Friday-Labs-Inc/friday-labs-os/docs/build/Locomotion Deck - Full Schematic.pdf

FRIDAY LABS - MARK 1 | Power, Isolation Domains & E-Stop

## BACKBONE INPUT

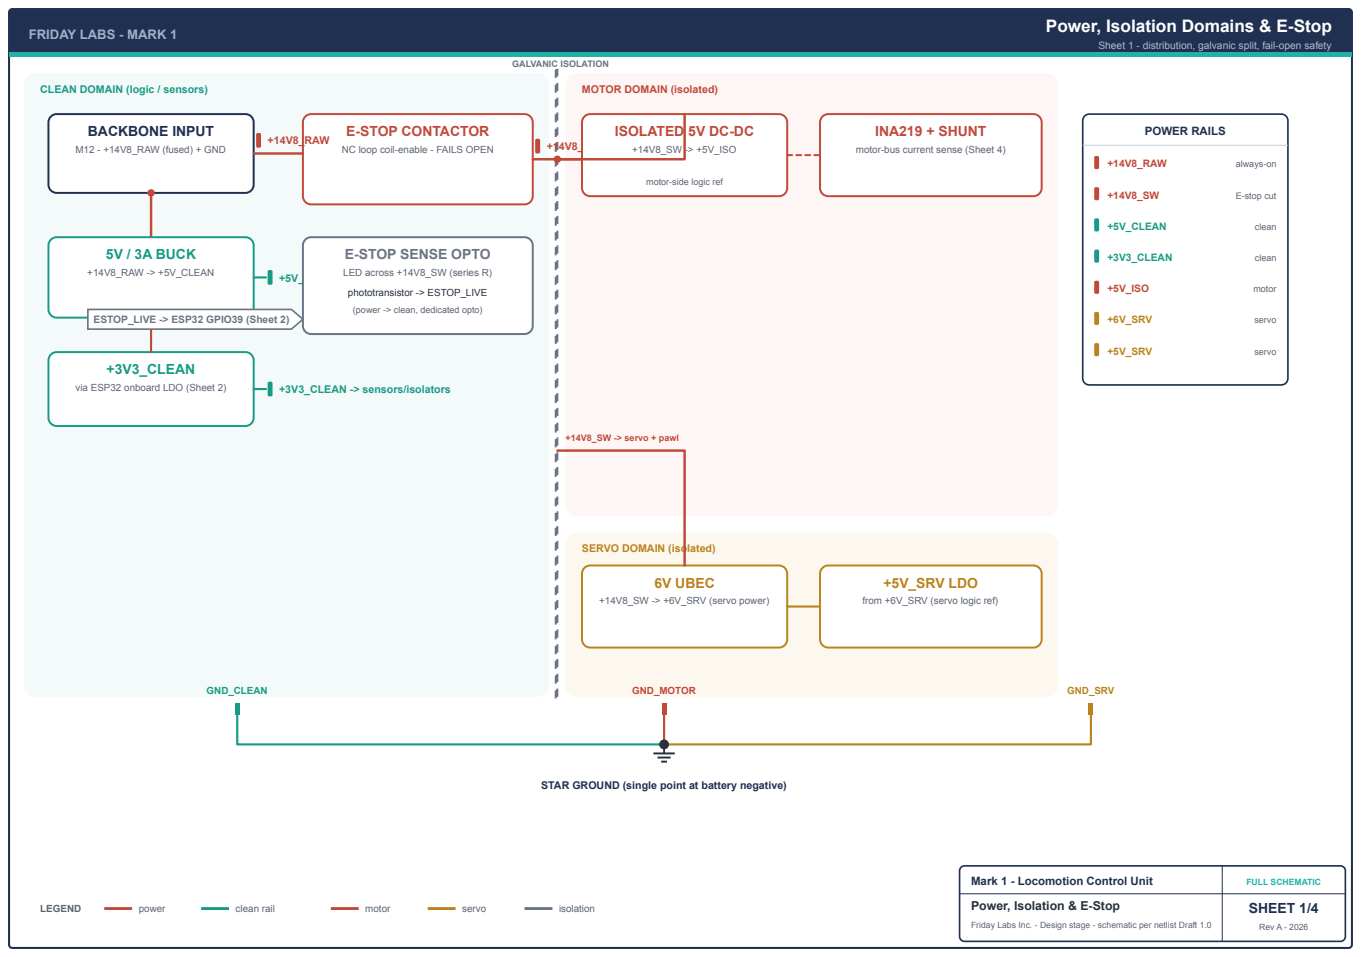
[picture p1: page 1]
CLEAN DOMAIN (logic / sensors); MOTOR DOMAIN (isolated); GALVANIC ISOLATION; M12 - +14V8_RAW (fused) + GND; E-STOP CONTACTOR; NC loop coil-enable - FAILS OPEN +14V8_RAW; 5V / 3A BUCK; +14V8_RAW -> +5V_CLEAN; +5V_CLEAN -> ESP32 (Sheet 2); +3V3_CLEAN -> sensors/isolators; ESTOP_LIVE -> ESP32 GPIO39 (Sheet 2); 6V UBEC; +14V8_SW -> +6V_SRV (servo power); +14V8_SW -> servo + pawl; POWER RAILS; +14V8_RAW; always-on; E-stop cut; +5V_CLEAN; clean; +3V3_CLEAN; +5V_ISO; motor; +6V_SRV; servo; +5V_SRV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

Sheet 1 - distribution, galvanic split, fail-open safety

ISOLATED 5V DC-DC
+14V8_SW -> +5V_ISO

INA219 + SHUNT
motor-bus current sense (Sheet 4)

motor-side logic ref

E-STOP SENSE OPTO
LED across +14V8_SW (series R)
phototransistor -> ESTOP_LIVE
(power -> clean, dedicated opto)

+3V3_CLEAN
via ESP32 onboard LDO (Sheet 2)

SERVO DOMAIN (isolated)

+5V_SRV LDO
from +6V_SRV (servo logic ref)

STAR GROUND (single point at battery negative)

Mark 1 - Locomotion Control Unit
Power, Isolation & E-Stop

Friday Labs Inc. - Design stage - schematic per netlist Draft 1.0

FRIDAY LABS - MARK 1 | Controller, I2C Sensors & Isolation Bank Sheet 2 - ESP32-S3 pinout, encoder mux tree, current-sense isolation

### ISOLATION BANK (ISO7741 x5)

#1 | DRV_PWM1..4 -> MDD10A PWM

#2 | DRV_PWM5-6, DIR1-2

#3 | DRV_DIR3..6

#4 | SRV_PWM1..4 -> servos

#5 | PAWL_REL -> FET (+3 spare)

All ISO7741 channels run clean -> power (4/0 part). E-stop sense is a separate opto (Sheet 1).

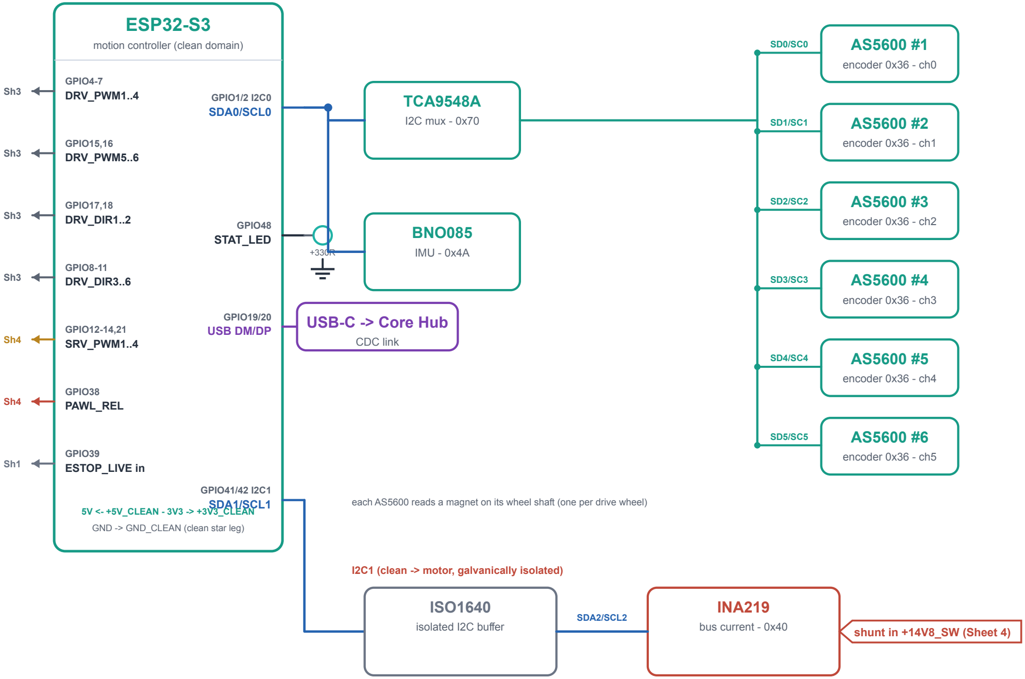
[picture p2: figure]
ESP32-S3; motion controller (clean domain); GPIO4-7 DRV_PWM1..4 Sh3; GPIO15,16 DRV_PWM5..6 Sh3; GPIO17,18 DRV_DIR1..2 Sh3; GPIO8-11 DRV_DIR3..6 Sh3; GPIO12-14,21 SRV_PWM1..4 Sh4; GPIO38 PAWL_REL Sh4; GPIO39 ESTOP_LIVE in Sh1; GPIO1/2 I2C0 SDA0/SCL0; GPIO48 STAT_LED; GPIO19/20 USB DM/DP; GPIO41/42 I2C1; GND -> GND_CLEAN (clean star leg); USB-C -> Core Hub; CDC link; TCA9548A; I2C mux - 0x70; BNO085; IMU - 0x4A; encoder 0x36 - ch0; encoder 0x36 - ch1; encoder 0x36 - ch2; encoder 0x36 - ch3; encoder 0x36 - ch4; encoder 0x36 - ch5; ISO1640; isolated I2C buffer; INA219; bus current - 0x40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

SDA1/SCL1 5V <- +5V_CLEAN - 3V3 -> +3V3_CLEAN

I2C0 (clean) - mux, IMU + 6 wheel encoders - pull-ups 4.7k -> +3V3_CLEAN

each AS5600 reads a magnet on its wheel shaft (one per drive wheel)

I2C1 (clean -> motor, galvanically isolated)

VCC1 3V3 / VCC2 +5V_ISO - pull-ups both sides

LEGEND | I2C | control | USB

### Mark 1 - Locomotion Control Unit

## Controller, Sensors & Isolation

FULL SCHEMATIC

## SHEET 2/4

FRIDAY LABS - MARK 1 | Drive Subsystem - 6 Channels (fully expanded) Sheet 3 - ESP32 -> ISO7741 x3 -> MDD10A x3 -> 6 drive motors

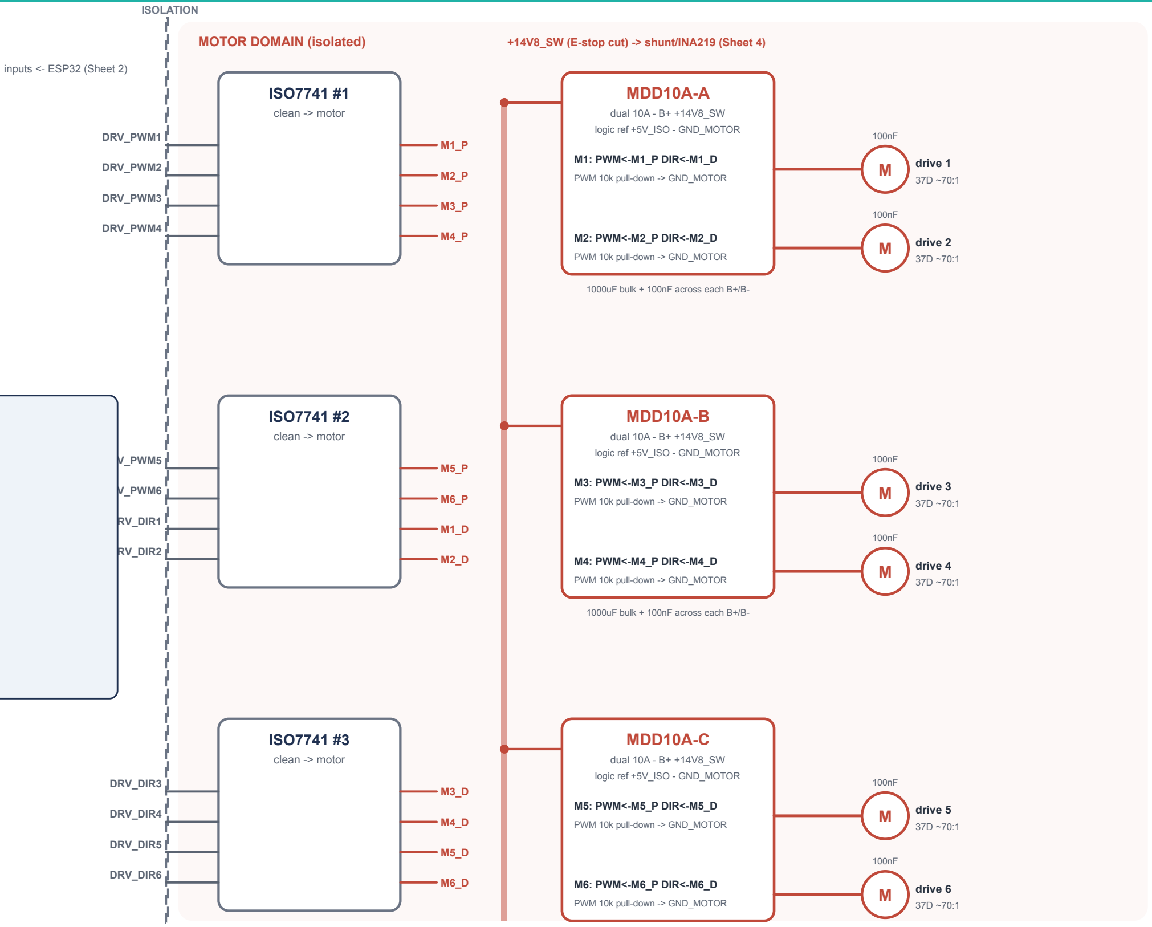
[picture p3: figure]
MOTOR DOMAIN (isolated); ISOLATION; inputs <- ESP32 (Sheet 2); ISO7741 #1; clean -> motor; DRV_PWM1; DRV_PWM2; DRV_PWM3; DRV_PWM4; ISO7741 #2; DRV_PWM5; DRV_PWM6; DRV_DIR1; DRV_DIR2; ISO7741 #3; DRV_DIR3; DRV_DIR4; DRV_DIR5; DRV_DIR6; MDD10A-A; dual 10A - B+ +14V8_SW; logic ref +5V_ISO - GND_MOTOR; M1: PWM<-M1_P DIR<-M1_D; PWM 10k pull-down -> GND_MOTOR; drive 1; M2: PWM<-M2_P DIR<-M2_D; drive 2; 1000uF bulk + 100nF across each B+/B-; MDD10A-B; M3: PWM<-M3_P DIR<-M3_D; drive 3; M4: PWM<-M4_P DIR<-M4_D; drive 4; MDD10A-C; M5: PWM<-M5_P DIR<-M5_D; drive 5; M6: PWM<-M6_P DIR<-M6_D; drive 6

1000uF bulk + 100nF across each B+/B-

+14V8_SW (E-stop cut) -> shunt/INA219 (Sheet 4)

### FAIL-SAFE ON SIGNAL LOSS

- Dead isolator / lost PWM -> motor-side 10k pull-down -> PWM low -> motor OFF.
- E-stop opens +14V8_SW -> MDD10A B+ removed -> all 6 drive motors dead.
- Pull-downs live on the isolated (power) side: hold the
safe state even if clean domain / isolators are unpowered.
- 37D-class gearmotor; AS5600 shaft encoder feedback
on I2C0 mux (Sheet 2).

Drive map: A=M1,M2 - B=M3,M4 - C=M5,M6

LEGEND | control | motor signal | power

### Mark 1 - Locomotion Control Unit

## Drive Subsystem x6

FULL SCHEMATIC

## SHEET 3/4

FRIDAY LABS - MARK 1 | Steering, Parking Pawls & Current Sense Sheet 4 - 4 steer servos, power-to-release pawls, motor-bus INA219

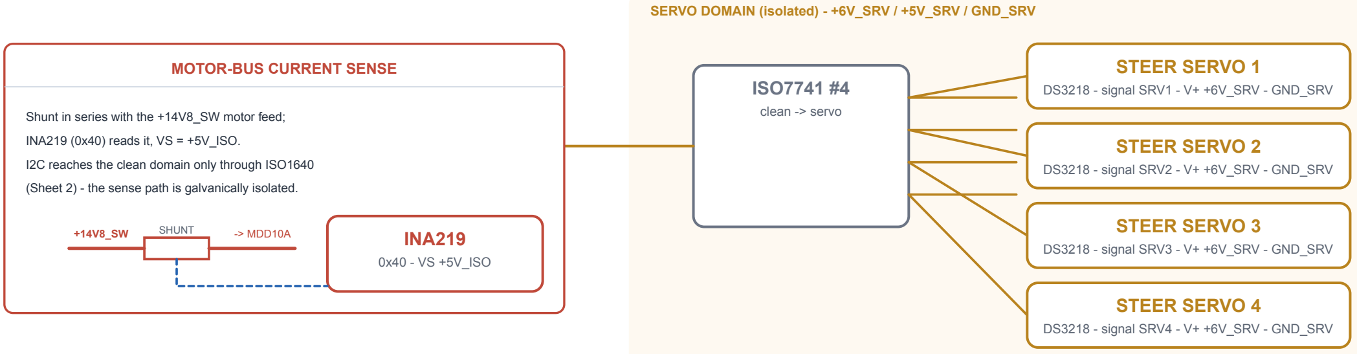
[picture p4: figure]
ISO7741 #4; clean -> servo; SRV_PWM1..4 (Sheet 2); STEER SERVO 1; STEER SERVO 2; STEER SERVO 3; STEER SERVO 4; MOTOR-BUS CURRENT SENSE; INA219 (0x40) reads it, VS = +5V_ISO.; SHUNT +14V8_SW; -> MDD10A; INA219; 0x40 - VS +5V_ISO

SERVO DOMAIN (isolated) - +6V_SRV / +5V_SRV / GND_SRV

DS3218 - signal SRV1 - V+ +6V_SRV - GND_SRV

DS3218 - signal SRV2 - V+ +6V_SRV - GND_SRV

DS3218 - signal SRV3 - V+ +6V_SRV - GND_SRV

DS3218 - signal SRV4 - V+ +6V_SRV - GND_SRV

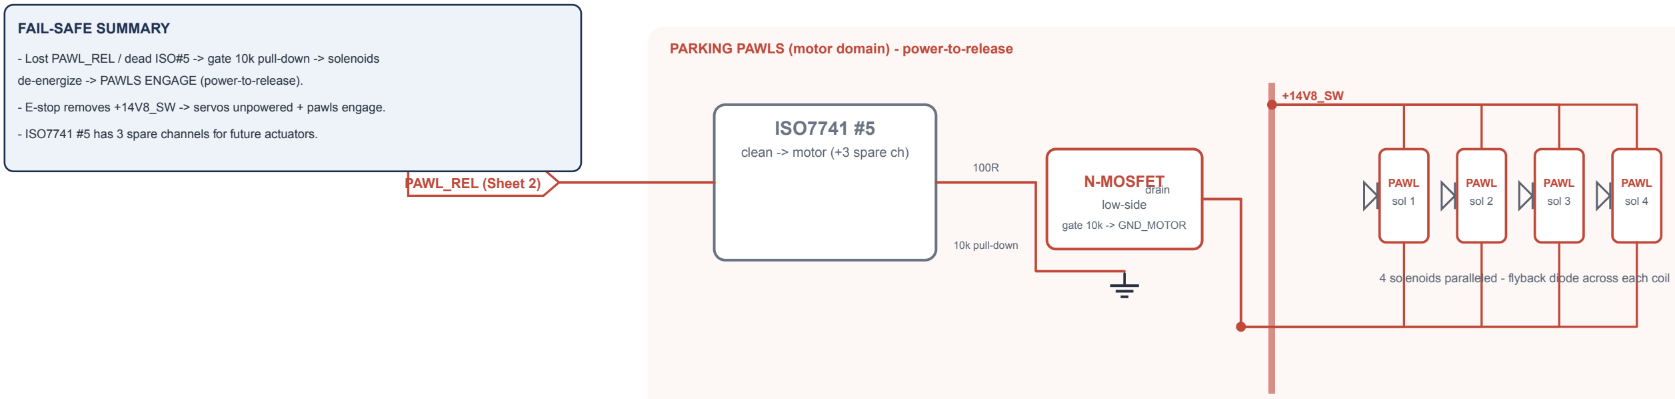
[picture p5: figure]
ISO7741 #5; clean -> motor (+3 spare ch); PAWL_REL (Sheet 2); N-MOSFET; low-side; gate 10k -> GND_MOTOR; 10k pull-down; drain; PAWL; sol 1; PAWL sol 2; PAWL sol 3; PAWL sol 4; FAIL-SAFE SUMMARY; de-energize -> PAWLS ENGAGE (power-to-release).

PARKING PAWLS (motor domain) - power-to-release

4 solenoids paralleled - flyback diode across each coil

Shunt in series with the +14V8_SW motor feed;

I2C reaches the clean domain only through ISO1640 (Sheet 2) - the sense path is galvanically isolated.

- Lost PAWL_REL / dead ISO#5 -> gate 10k pull-down -> solenoids
- E-stop removes +14V8_SW -> servos unpowered + pawls engage.
- ISO7741 #5 has 3 spare channels for future actuators.
LEGEND | servo signal | motor | power | I2C

### Mark 1 - Locomotion Control Unit

## Steering, Pawls & Current Sense

FULL SCHEMATIC

## SHEET 4/4
