Friday-Labs-Inc/friday-labs-os/frames_2026-07-19_11.41.01.pdf

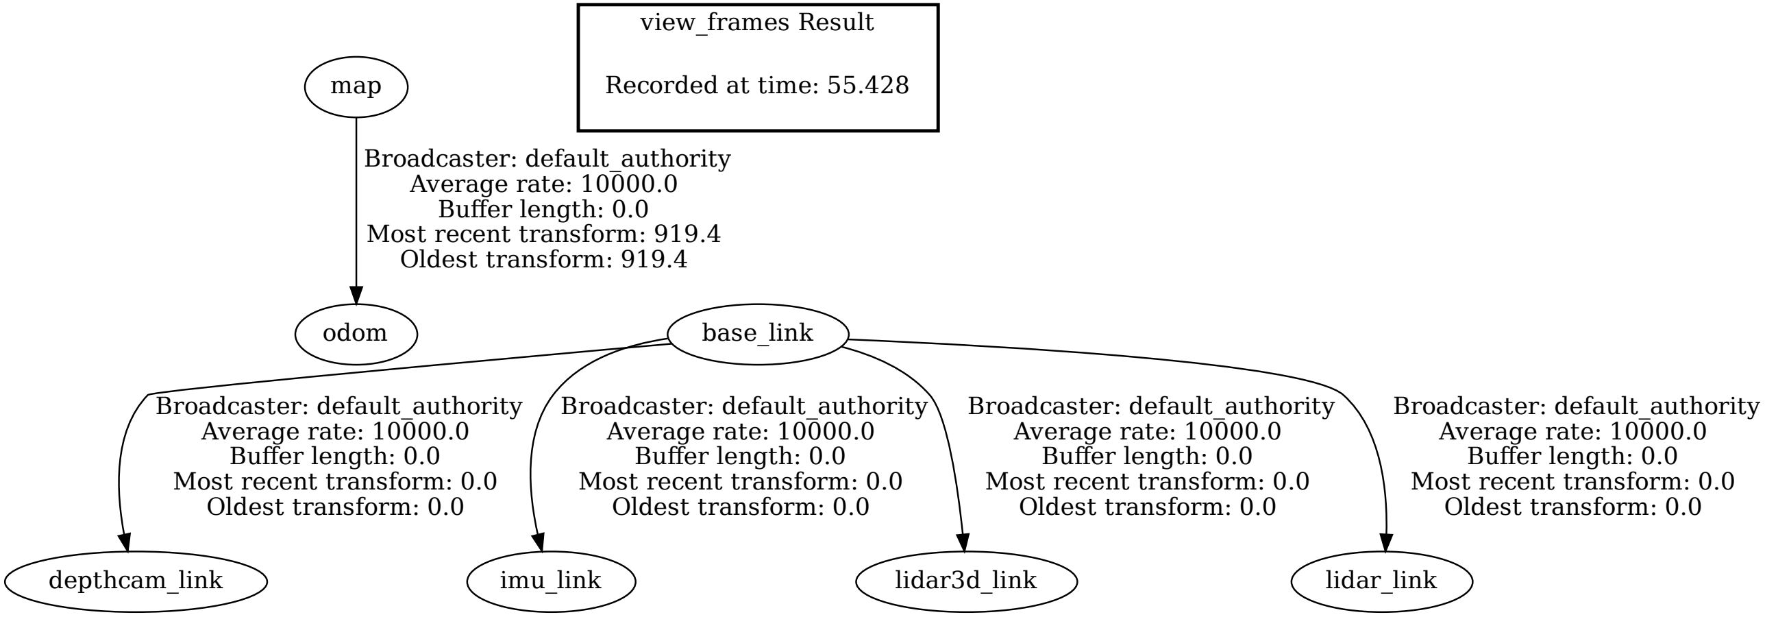
[picture p6: figure]
view_frames Result; map; odom; Broadcaster: default_authority Average rate: 10000.0 Buffer length: 0.0 Most recent transform: 919.4 Oldest transform: 919.4; base_link; depthcam_link; Broadcaster: default_authority Average rate: 10000.0 Buffer length: 0.0 Most recent transform: 0.0 Oldest transform: 0.0; imu_link; lidar3d_link; lidar_link; Recorded at time: 55.428
