Friday-Labs-Inc/friday-labs-os/(list of files, cad)

Other CAD files:
Mechanics/reference-models/howtomechatronics-replica/Perseverance_Replica_Assembly.step
Mechanics/reference-models/howtomechatronics-replica/stl/Accessories - Not functional parts/Accessories - front panels.STL
Mechanics/reference-models/howtomechatronics-replica/stl/Cameras Unit/Cam base motor mount.STL
Mechanics/reference-models/howtomechatronics-replica/stl/Main Functional Parts/Wheel 5 joint motor mount - Mirrored.STL
src/friday_description/meshes/knuckle_fl.stl
Mechanics/reference-models/howtomechatronics-replica/stl/Accessories - Not functional parts/Accessories p19-2.STL
Mechanics/reference-models/howtomechatronics-replica/stl/Cameras Unit/Cams servo mount.STL
Mechanics/reference-models/howtomechatronics-replica/stl/Main Functional Parts/Base frame back bracket v2.STL
src/friday_description/meshes/wheel.stl
Mechanics/reference-models/howtomechatronics-replica/stl/Accessories - Not functional parts/UHF Antenna.STL
Mechanics/reference-models/howtomechatronics-replica/stl/Cameras Unit/Cams tube p3.STL
Mechanics/reference-models/howtomechatronics-replica/stl/Main Functional Parts/Rim and DC Motor Coupler.STL
src/friday_description/meshes/chassis.stl
Mechanics/reference-models/howtomechatronics-replica/stl/Accessories - Not functional parts/Accessories p15-3.STL
Mechanics/reference-models/howtomechatronics-replica/stl/Cameras Unit/Cams servo link.STL
Mechanics/reference-models/howtomechatronics-replica/stl/Main Functional Parts/Wheel 3 Joint Servo Mount.STL
src/friday_description/meshes/knuckle_fr.stl
Mechanics/reference-models/howtomechatronics-replica/stl/Accessories - Not functional parts/Accessories p6-2 mirrored.STL
Mechanics/reference-models/howtomechatronics-replica/stl/Cameras Unit/Cams accessories 3.STL
Mechanics/reference-models/howtomechatronics-replica/stl/Main Functional Parts/Diff bar link.STL
Mechanics/reference-models/howtomechatronics-replica/stl/Accessories - Not functional parts/Accessories p5 holder.STL
Mechanics/reference-models/howtomechatronics-replica/stl/Cameras Unit/Cams accessories.STL
Mechanics/reference-models/howtomechatronics-replica/stl/Main Functional Parts/Wheel 1 Joint Servo Mount.STL
Mechanics/reference-models/howtomechatronics-replica/stl/Accessories - Not functional parts/Accessoires p1-2.STL
Mechanics/reference-models/howtomechatronics-replica/stl/Cameras Unit/Cams accessories 2.STL
Mechanics/reference-models/howtomechatronics-replica/stl/Main Functional Parts/Bogie joint p1.STL
Mechanics/reference-models/howtomechatronics-replica/stl/Accessories - Not functional parts/Accessories p20-1.STL
Mechanics/reference-models/howtomechatronics-replica/stl/Cameras Unit/Cams servo mount p2.STL
Mechanics/reference-models/howtomechatronics-replica/stl/Main Functional Parts/Wheel v.1.STL
Mechanics/reference-models/howtomechatronics-replica/stl/Accessories - Not functional parts/Accessories p19 - top panel.STL
Mechanics/reference-models/howtomechatronics-replica/stl/Cameras Unit/Cams accesories 1-2.STL
Mechanics/reference-models/howtomechatronics-replica/stl/Main Functional Parts/Bogie Joint p2.STL
Mechanics/reference-models/howtomechatronics-replica/stl/Accessories - Not functional parts/Accessories p2 - back right - mirrored.STL
Mechanics/reference-models/howtomechatronics-replica/stl/Cameras Unit/Cams accessories 5.STL
Mechanics/reference-models/howtomechatronics-replica/stl/Main Functional Parts/Rim.STL
Mechanics/reference-models/howtomechatronics-replica/stl/Accessories - Not functional parts/RTG pipes 1.STL
Mechanics/reference-models/howtomechatronics-replica/stl/Cameras Unit/Cams tube 2.STL
Mechanics/reference-models/howtomechatronics-replica/stl/Main Functional Parts/Rocker joint p2 - Mirrored.STL
Mechanics/reference-models/howtomechatronics-replica/stl/Accessories - Not functional parts/Accessories p6.STL
Mechanics/reference-models/howtomechatronics-replica/stl/Cameras Unit/Cam base bracket.STL
Mechanics/reference-models/howtomechatronics-replica/stl/Main Functional Parts/Bogie Joint p2 - Mirrored.STL
Mechanics/reference-models/howtomechatronics-replica/stl/Accessories - Not functional parts/Accessories p19- top left.STL
Mechanics/reference-models/howtomechatronics-replica/stl/Cameras Unit/Cams accessories 4.STL
Mechanics/reference-models/howtomechatronics-replica/stl/Main Functional Parts/Differential Bar p2.STL
Mechanics/reference-models/howtomechatronics-replica/stl/Accessories - Not functional parts/Accessories p14.STL
Mechanics/reference-models/howtomechatronics-replica/stl/Cameras Unit/Camera holder.STL
Mechanics/reference-models/howtomechatronics-replica/stl/Main Functional Parts/Wheel 4 Joint Servo Mount - Mirrored.STL
Mechanics/reference-models/howtomechatronics-replica/stl/Accessories - Not functional parts/UHF Antenna base.STL
Mechanics/reference-models/howtomechatronics-replica/stl/Cameras Unit/Cam tube p1.STL
Mechanics/reference-models/howtomechatronics-replica/stl/Main Functional Parts/Differential Bar p1.STL
Mechanics/reference-models/howtomechatronics-replica/stl/Accessories - Not functional parts/Accessories p1 - 1.STL
Mechanics/reference-models/howtomechatronics-replica/stl/Cameras Unit/Cams housing top cover.STL
Mechanics/reference-models/howtomechatronics-replica/stl/Main Functional Parts/Electronics holder p1.STL
Mechanics/reference-models/howtomechatronics-replica/stl/Accessories - Not functional parts/Accessiories p1-1.STL
Mechanics/reference-models/howtomechatronics-replica/stl/Cameras Unit/Cams tube p4.STL
Mechanics/reference-models/howtomechatronics-replica/stl/Main Functional Parts/Servo coupler.STL
Mechanics/reference-models/howtomechatronics-replica/stl/Accessories - Not functional parts/Accessories p1 - 2.STL
Mechanics/reference-models/howtomechatronics-replica/stl/Cameras Unit/Cams accessories 2-1.STL
Mechanics/reference-models/howtomechatronics-replica/stl/Main Functional Parts/Electronics holder p2.STL
Mechanics/reference-models/howtomechatronics-replica/stl/Accessories - Not functional parts/Accessories p18.STL
Mechanics/reference-models/howtomechatronics-replica/stl/Cameras Unit/Cams housing.STL
Mechanics/reference-models/howtomechatronics-replica/stl/Main Functional Parts/Rocker joint base.STL
Mechanics/reference-models/howtomechatronics-replica/stl/Accessories - Not functional parts/RGT cover bracket.STL
Mechanics/reference-models/howtomechatronics-replica/stl/Cameras Unit/Cams cover bottom.STL
Mechanics/reference-models/howtomechatronics-replica/stl/Main Functional Parts/Shaft Coupler - 5mm to 5mm (v2 for 5mm pulleys).STL
Mechanics/reference-models/howtomechatronics-replica/stl/Accessories - Not functional parts/RTG pipes 3 - mirrored.STL
Mechanics/reference-models/howtomechatronics-replica/stl/Main Functional Parts/Bracker for dif bar.STL
Mechanics/reference-models/howtomechatronics-replica/stl/Accessories - Not functional parts/RTG support 1.STL
Mechanics/reference-models/howtomechatronics-replica/stl/Main Functional Parts/Rocker Joint.STL
Mechanics/reference-models/howtomechatronics-replica/stl/Accessories - Not functional parts/RTG pipes 2.STL
Mechanics/reference-models/howtomechatronics-replica/stl/Main Functional Parts/Wheel 2 joint motor mount.STL
Mechanics/reference-models/howtomechatronics-replica/stl/Accessories - Not functional parts/Accessories p14-2.STL
Mechanics/reference-models/howtomechatronics-replica/stl/Main Functional Parts/Wheel 1 Joint p2.STL
Mechanics/reference-models/howtomechatronics-replica/stl/Accessories - Not functional parts/RTG pipes 3.STL
Mechanics/reference-models/howtomechatronics-replica/stl/Main Functional Parts/Base frame front and back bracket.STL
Mechanics/reference-models/howtomechatronics-replica/stl/Accessories - Not functional parts/Accessories p17 - top front left.STL
Mechanics/reference-models/howtomechatronics-replica/stl/Main Functional Parts/Wheel 1 Joint.STL
Mechanics/reference-models/howtomechatronics-replica/stl/Accessories - Not functional parts/Accessories p21.STL
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
