Friday-Labs-Inc/friday-labs-os/(commit log)

2026-06-19 docs: initial commit — Phase 1 design dossier complete
    24 internally-aligned documents covering full Phase 1 design for the Mark 1
    modular autonomous research rover:
    - 5 foundational architecture docs (compute, OS, comms, interface contract,
    sim environment)
    - 13 design-gap addendums (authority lease, safe-stop budget, sensor ownership,
    power budget, AI inference, friday_msgs schema conventions, mTLS security,
    OTA strategy, mission logging, Stage 5 acceptance, Spark authority,
    mechanical reference, mmWave human detection)
    - 3 module specs (Locomotion Control Unit, Adaptive Research Module,
    Aerial Companion Bay)
    - Phase 1 Implementation Kickoff onboarding
    Plus 8 project-specific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
2026-06-19 docs: add deck-by-deck electronics design
    Six new electronics documents under docs/electronics/ capturing the full
    electrical design pass:
    - Electronics Backbone: distributed power tree (fused raw 14.8V per deck),
    NC-loop physical E-stop on motion power, single-point star ground, central
    fuse block + per-deck protection, M8/M12 bulkhead connectors, custom-PCB
    build medium, plus cross-cutting bus comparator / supercap / load switches.
    - Core Hub: 5V/6A buck->GPIO + usb_max_current_enable override, powered USB 3.0
    hub, conduction cooling, NVMe boot, supercap power-fail shutdown.
    - Telemetry: dual independent LoRa (Pi + ESP32), 4G LTE M.2 (5G-ready),
    backup-ESP32 reboot authority via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
2026-06-19 docs: add Locomotion deck build package (bottom deck)
    First buildable deck package, under docs/build/:
    - Electrical BOM with real, verifiable parts (Cytron MDD10A, ESP32-S3,
    Adafruit BNO085, AS5600 + TCA9548A, ISO7741/ISO1640 isolators, INA219,
    pawl solenoids) and ~costs.
    - ESP32-S3 pinout/wiring map: drive PWM on MCPWM, servo PWM on LEDC
    (solves the 10-PWM > 8-LEDC-channel constraint), dual I2C with the
    motor-domain INA219 behind an I2C isolator, fail-safe-on-signal-loss
    control lines across the galvanic barrier.
    - Power-domain & isolation diagram: clean / motor / servo domains meeting
    only at the battery-negative star point.
    - Layered safe-stop wiring (software brake -> 100ms w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
2026-06-19 docs: resolve Locomotion drive-motor sizing
    Worked the drive-motor sizing calc (11kg, 130mm wheels, 20 deg climb,
    1 m/s, 6WD, Crr=0.10):
    - Wheel speed ~147 RPM; tractive force 47 N; 0.51 N.m/motor steady,
    design target >=1.0 N.m stall.
    - Motor: 12V 37D-class ~70:1 (~150 RPM, ~1.2-1.3 N.m stall, ~5.5A stall).
    - Confirms 10 A/channel driver (~1.8x stall headroom) -> Cytron 10A class.
    - Firmware note: cap drive PWM duty ~71% so the 4S bus (up to 16.8V)
    doesn't over-volt 12V motors.
    - Power note: sustained 20 deg climb draws ~100-160W, above the 80W
    motor-peak budget line -- mission-planner consideration.
    Closes the gear-ratio and driver-rating open items.
2026-06-19 docs: lock Locomotion driver choice — 3x MDD10A + 1 spare
    Confirmed by the drive-motor sizing calc (10 A/channel, ~1.8x stall
    headroom). Dual MDD10A (PWM+DIR), not the RC-oriented MDDRC10.
2026-06-19 docs: close Locomotion open items — steering servos + pawls
    - Steering: 4x metal-gear servo (DS3218/DS3225-class, 20-25 kg.cm, 6V,
    >=180deg), open-loop PWM. Sized ~4x margin over in-place scrub (~0.5 N.m).
    - Pawls: 4x on the corner wheels (locking corners prevents chassis
    translation; middle wheels redundant for holding). Tooth bears
    ~0.45-0.60 N.m; solenoid actuates only. No pawl redundancy -> reliable
    seating noted.
    Locomotion deck sizing now fully resolved; remaining open items are
    mechanical detailing + GPIO finalization + OSR BOM cross-reference.
2026-06-19 docs: add Locomotion deck pin-level schematic (netlist)
    Net-by-net electrical spec driving the KiCad capture:
    - Power rails/nets across clean/motor/servo domains (+14V8_RAW/_SW,
    +3V3_CLEAN, +5V_ISO, +6V_SRV/+5V_SRV, three star-ground legs).
    - ESP32-S3 reference pin assignment (drive on MCPWM, servo on LEDC,
    dual I2C, pawl, e-stop sense, USB).
    - ISO7741 x5 channel map (all clean->power); e-stop-live sense via a
    dedicated optocoupler (reverse direction, not the ISO7741 bank).
    - Net-by-net connections, per-device power/address summary, and
    passives/protection with real values.
    - Fail-safe-on-signal-loss nets: motor-side PWM pull-downs (motors off)
    and pawl MOSFET gate pull-down (pawls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
2026-06-19 docs: add standalone Locomotion schematic SVGs (deck + 3 channels)
    Four theme-adaptive standalone SVGs under docs/build/diagrams/ (self-contained
    styling + prefers-color-scheme, render on GitHub light/dark and in editors),
    linked from the pin-level schematic doc:
    - locomotion-deck-wiring.svg — deck block wiring, three power domains
    - locomotion-drive-channel.svg — drive cell (repeats x6)
    - locomotion-servo-channel.svg — servo cell (repeats x4), open-loop
    - locomotion-pawl-channel.svg — pawl driver with fail-safe gate pull-down + flyback
2026-06-19 assets: add Perseverance reference mesh via git-LFS; ignore local .mcp.json
    - Track *.obj / *.stl through git-LFS (joining the existing *.glb / *.usdz
    rules) so the ~30MB Perseverance reference geometry is versioned without
    bloating git history. The small .mtl stays in normal git.
    - Mechanics/reference-models/perseverance/converted/: 25042_Perseverance
    .obj/.stl/light.stl (LFS) + .mtl — mechanical-anatomy reference for the
    rocker-bogie design.
    - Gitignore .mcp.json (machine-specific MCP server config with local paths).
    [25042_Perseverance.obj, 25042_Perseverance.stl, 25042_Perseverance_light.stl]
2026-06-19 docs: record Perseverance reference-model scale factor (130mm wheel)
    Anchor on the locked 130mm wheel: real Perseverance wheel 525mm ->
    uniform scale 0.2476 (~1:4). Resulting footprint ~743 x 668 mm, within
    the 60-90cm envelope. Includes the measure-then-scale Blender/CAD
    procedure and caveats (verify 525mm source; meshes may not be true-scale).
2026-06-19 docs: lock true-Perseverance proportions as the build target
    Decision: hold true Perseverance proportions at 0.2476x scale (anchored on
    the 130mm wheel) -> body ~743 x 668 x 545 mm, within the 60-90cm envelope.
    - Mechanical Design Reference: locked build target; the scaled mesh is now
    the build's DIMENSIONAL reference (not just a study aid). Added a derived-
    dimensions table (wheelbase/track/clearance/pivots/mast to be MEASURED off
    the scaled mesh). OSR demoted from build base to rocker-bogie MECHANISM
    donor -- no stock kit fits dimensionally; expect CAD re-spacing. Mass/size
    row updated to ~74cm / ~11kg.
    - Build package + Index updated to match (OSR = mechanism donor, re-proporti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
2026-06-19 mech: re-anchor scale to measured mesh — 140mm wheel, 0.2668x; add working .blend
    After measuring the Perseverance GLB in Blender (wheel Ø 0.526 m matches NASA's
    526 mm — mesh is dimensionally faithful; wheel-span 2.785 m, not the assumed
    3.0 m), the build re-anchors on the 743 mm body length:
    - Scale 0.2668x (was 0.2476x); wheel 140 mm (was 130 mm).
    - Body ~743 x 722 x 596 mm; deck plate 555 x 413 x 220 mm; ground clearance
    ~180 mm; wheelbase ~603 mm (hub-center confirm pending).
    - Mechanical Design Reference -> v1.1 with measured-dimensions table.
    - Drive-motor sizing re-derived for 140 mm (137 RPM, 3.29 N.m, ~0.55 N.m/motor,
    ~5.9 A stall): 37D ~70:1 motor and MDD10A 10A driver st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
    [perseverance_rolling_chassis.blend, perseverance_scaled.blend]
2026-06-19 docs: add Power & E-stop backbone build package
    The shared electrical foundation every deck plugs into, turning the locked
    Electronics Backbone architecture into a buildable spec:
    - BOM: 4S Li-ion 21700 + smart BMS (SOC telemetry), master isolator + 30A
    fuse, ideal-diode reverse-polarity, solid-state pre-switch (soft-start),
    fail-open mechanical E-stop contactor, NC mushroom button, central fuse
    blocks, bus-fail supervisor, star-ground bus, M12 inter-deck harness, charger.
    - RAW (always-on) vs SW (E-stop-cut motion) bus split: compute + deck logic
    stay alive through an E-stop; only motion power is cut -> Locomotion pawls drop.
    - E-stop loop spec (NC, fail-open, two-layer contactor +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
2026-06-19 docs: add deck layout, electronics-driven sizing & analytical CG
    Closes the 'deck footprint / stack order undocumented' open item with a
    PROPOSED packaging + sizing + center-of-gravity analysis:
    - Deck allocation (power+Locomotion lower; 3 Pis upper; mast + Spark bay top).
    - Electronics-driven sizing: boards use <30% of each deck level's area and
    ~160/220mm height -> the Perseverance-proportional deck is oversized for the
    electronics; proportions drive size, height is the tighter axis.
    - Analytical CG (total ~10.7kg): CG_x -16mm (~5% rear, balanced), CG_y ~0
    (centered), CG_z ~217mm (low). Tip angles ~53deg long / ~55deg lat vs the
    20deg climb / 15deg hold -> very stable; no battery r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
2026-06-19 docs: record Blender 3D CG verification + mass reconciliation
    Blender pass confirms the analytical CG and verdict:
    - CG (-21.7, +0.5, 189) mm itemized (7.67 kg) — brackets the analytical
    ~217 mm (with ~3 kg enclosure); both low, centered, stable.
    - Tip angles 56-60 deg >> 20 deg slope; tip-over not a concern.
    - Rear-bias -3.6% (inside -10% trigger) -> battery STAYS rear, no dossier
    tension; RTG-analog placement preserved.
    - Climb traction: ~35% front on a 20 deg ascent -> no pitch-back.
    - Mass reconciliation: itemized 7.67 kg (the brief's 9.7 kg was a mis-add)
    + ~3 kg enclosure/structure ~= 10.7 kg -> ~11 kg with hardware.
    3D CG verification open item closed.
2026-06-19 docs: fold in inter-deck structure (Architecture A) + final CG
    Blender modeled the inter-deck structure (perseverance_structure.blend):
    - Option A (Al plates + 6 standoffs) recommended & modeled; B (side-rail
    cage) and C (monocoque) deferred to Mark 2.
    - Base 2.5mm @z181 / mid 2.5mm @z269 / lid radiator 2.0mm @z398, 40%
    lightening; Core->lid Al thermal column 22x22x58.
    - Structure 3.09 kg -> full-build 10.76 kg; FINAL CG (-14.9, +0.4, 218) mm
    (lands on the analytical 217 mm estimate exactly), -2.5% rear, tip angles
    52.8/55.5/54.9 deg >> 20 deg -> stable.
    - Height 162/220 mm -> 58 mm margin, no overrun. All 8 constraints honored.
    - CG verification + enclosure-proxy open items closed;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
2026-06-19 assets: commit CG + inter-deck structure Blender models (LFS)
    Preserve the 3D artifacts behind the documented CG / structure results:
    - perseverance_rolling_chassis.blend (updated: CG mass proxies)
    - perseverance_cg.blend (CG analysis)
    - perseverance_structure.blend (inter-deck Architecture A: plates + 6
    standoffs + lid radiator + Core->lid thermal column)
    All via git-LFS. (mmWave doc left to the parallel radar session.)
    [perseverance_cg.blend, perseverance_rolling_chassis.blend, perseverance_structure.blend]
2026-06-19 docs: verify inter-deck structure is inside the body envelope
    The apparent 'doubled height' was a render artifact, not a placement error:
    an x-ray made the roof payload (mast + Spark bay + RPLIDAR, above z=400) plus
    a stray oversized reference plane read as a cage on top. Numerical check +
    clean re-render confirm the inter-deck structure sits entirely within the
    220mm body (z181-401, lid flush at z=400); body unchanged, overall height
    still 596mm. Final CG (-15.2, +0.4, 217.1) mm, total 10.61 kg, tip ~53-55deg
    -> low + stable. Stray plane removed, lid dropped flush.
2026-06-19 docs: pivot deck to modular bolt-on enclosures, battery centered
    Supersede the stacked-plate inter-deck (Architecture A) with self-contained
    mini-PC-style module boxes that bolt to the base plate:
    - Battery CENTERED as the CG anchor (top-loading hatch + blind-mate connector
    for hot-swap); Locomotion rear; 3 compute boxes front; single layer.
    - Sensor bay: boxes use only ~95mm of 220mm -> ~117mm clear full-width
    (~157mm above shorter boxes). RD-03D radar front-facing in front headroom,
    RPLIDAR roof (360), RealSense+cam mast.
    - Architecture A kept as history (its verified CG/mass still validate the
    chassis). Mech Ref: rear-power 'RTG analog' superseded by centered battery.
    - Two earlie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
2026-06-19 docs: modular deck re-model verified — CG centered + lower
    Blender modular re-model (perseverance_modular.blend) verified:
    - 5 sealed bolt-on boxes, single layer; battery centered (top-load hatch +
    blind-mate); stacked plates/standoffs/thermal-column removed.
    - Total 10.41 kg (structure 2.74 kg). CG (+3.0, 0.0, 205.1) mm = +0.5%
    wheelbase -> CENTERED, and LOWER (205 vs 217 mm plate-stack). Tip 55.5-56.5deg.
    - Sensor bay verified: ~122mm above battery, ~162mm above compute.
    - Body 555x413x220 + overall 596mm unchanged.
    Modular re-model open item closed; drivetrain breakout now in progress.
    Commit canonical perseverance_modular.blend via LFS.
    [perseverance_modular.blend]
2026-06-19 docs: record drivetrain breakout measurements; close wheelbase/track TBD
    Blender drivetrain breakout (perseverance_drivetrain.blend, 21 named objects):
    - Wheelbase 603 mm (hubs x=+/-301.5); track 567 mm front/rear, 632 mm middle
    (corners y=+/-283.5, middle y=+/-316.0); wheel 140 mm all 6 confirmed.
    - Hub centers + estimated pivot positions recorded in Mechanical Design Reference;
    pivots flagged estimated (fused decorative arms) -> confirm before bearings.
    - Wheel/motor-mount rebuild markup sent: functional 140mm wheels + hub adapter,
    common corner knuckle (37D motor + DS3218 servo, vertical steer axis),
    middle motor brackets, structural arms + cable channels, functional diff-bar.
    - I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
2026-06-20 docs: add full 4-sheet Locomotion deck schematic set
    Render the entire Locomotion deck as a print-ready, A3-landscape vector
    PDF (4 sheets) plus source SVGs, faithful to the Pin-Level netlist:
    1. Power, Isolation Domains & E-Stop
    2. Controller, I2C Sensors & Isolation Bank
    3. Drive Subsystem - 6 channels fully expanded
    4. Steering, Parking Pawls & Current Sense
    Add tools/locomotion_schematic.py generator (SVG -> vector PDF via
    rsvg-convert) and index the set from the Pin-Level Schematic doc.
2026-06-20 feat: Phase 2 walking skeleton — friday_msgs + module-agent base + Core Hub + Locomotion stub
    Stand up the ROS 2 Jazzy software workspace and the lifecycle-orchestration
    walking skeleton (Stage 2 of the seven-stage sim bring-up):
    - friday_msgs: the versioned interface contract (Mark1Header packed-semver
    header, Heartbeat, HealthStatus, ModulePresence, RegisterModule.srv).
    - friday_module_agent: reusable LifecycleNode base implementing the
    module-agent contract (register on configure, 5 Hz heartbeat + health
    while active, safe-state on deactivate) plus the locked 4-profile QoS policy.
    - friday_core_hub: module-registry (major-version rule), lite health monitor
    (OK/DEG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
2026-06-20 docs: Phase 2 walking-skeleton walk-through (beginner-traceable)
    Strong per-phase documentation, written in parallel with the code (same branch):
    a walk-through of the lifecycle-orchestration skeleton an 8th-grade CS student
    can trace, run, and debug — glossary, architecture picture, annotated boot
    trace, design decisions + the QoS-mismatch bug story, an "if this breaks, look
    here" debugging guide, verification evidence, and the per-phase doc template.
    Linked from the Mark 1 Index.
2026-06-20 docs: add living Friday Labs OS Software Manual (grows per foundation phase)
    Introduce the Software Manual as the front door for the OS software: shared
    front matter every chapter builds on (one-page overview, whole-system
    architecture, workspace map, build/run + dev workflow, the debugging toolkit,
    a plain-language glossary) and a foundation-phase map (Phase 1 design ✅,
    Phase 2 walking skeleton ✅, Phases 3–5 planned). The Phase 2 walk-through
    becomes its first implemented chapter; manual and chapter cross-link, and the
    Mark 1 Index now leads its software section with the manual.
2026-06-20 docs: add Phase 0 Genesis chapter — from empty repo to the first line of code
    Open the Software Manual at line one so any reader can trace the codebase from
    its birth: an empty folder -> the first package (friday_msgs, language-first)
    -> the literal first line of code (uint8 protocol_major, the version everything
    checks first) -> the first message, the first service, the first build, and the
    first line that runs (rclpy.init()). Reproducible from zero. Wired in as the
    "read first" chapter in the manual's How-to-read, the phase map (Phase 0 row),
    and the Mark 1 Index.
2026-06-21 feat: Phase 3 — closed-loop motion (MotionCommand -> Odometry)
    Add friday_msgs/MotionCommand (velocity command + the contract's authority
    fields) and teach the Locomotion agent to close the loop: subscribe cmd_motion
    (critical_reliable), run a unicycle motion model, and publish nav_msgs/Odometry
    (state_default) at 20 Hz on the odom frame. Safe-state stops integration and
    zeroes the command. Software model now; Gazebo/gz_ros2_control publishes the
    same Odometry later (sim/hardware parity).
2026-06-21 docs: Phase 3 chapter — closed-loop motion (parallel with the code)
    Add the Phase 3 walk-through (MotionCommand -> unicycle model -> Odometry) with
    the verified command-to-odometry trace, the frame/QoS decisions (incl. the
    transient_local command gotcha), a debugging guide, and honest not-done scope
    (no real drivers, authority not enforced, Command Center boundary still to come).
    Flip the manual's Phase 3 map row to in-progress, add glossary terms, extend the
    reading story, and link from the Mark 1 Index.
2026-06-21 docs: Command Center blueprint — second pass (corrections + newer tech)
    Critical re-read. Corrections: telemetry is time-series → add a TSDB
    (TimescaleDB/ClickHouse), don't dump it in MariaDB; login != signing (OIDC +
    WebAuthn for login, local HSM/PKCS#11 agent for envelope signing — WebAuthn
    can't sign a custom envelope); add observability (OTel/Prometheus/Grafana/Loki);
    discipline rover clock to GPS for expiry validation. Newer tech: Foxglove for
    live telemetry/3D/replay (don't rebuild viz); AI operator copilot (Claude —
    drafts, human signs); evaluate Zenoh/rmw_zenoh as the rover↔cloud transport and
    NATS JetStream as the internal bus; offline/satellite maps (MapLibre). Diagram
    up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
2026-06-21 docs: Command Center deployment topology, connectivity & fleet monitoring
    Close three gaps the cloud-first first draft missed, with an edge-first topology
    diagram + companion doc:
    1. Friday Labs device-monitoring plane — two monitoring planes (operational =
    customer @ edge; device-health = Friday Labs @ HQ via store-and-forward) so HQ
    catches a Mark 1 failure before the customer notices. Opt-in / air-gappable
    for defense; mission data stays with the customer.
    2. 20-30 km field link — tiered multi-path: LoRa (emergency, bytes) · 900MHz/
    MANET mesh (defense/forest, NLoS) · 5 GHz directional (open, LoS, 100s Mbps) ·
    satellite backhaul; Spark as aerial relay. Rover multi-p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
2026-06-21 docs: Command Center 7-expert architecture review (comparative analysis)
    Round 1 multi-expert review (application · system · connectivity · radio/RF ·
    cloud · data lake · data pipeline). Scorecard (concept ~4, implementation ~2.4),
    ranked consensus gaps with P0/P1/P2 plan: nonce durability across reboot/bearer-
    switch, offline-revocation reconnect handshake, edge control-plane cache, the
    event-sourced edge<->cloud sync contract (CRDT allowlist), retire the duty-cycle-
    illegal "always-on LoRa e-stop" (firmware watchdog is the real safe-stop),
    concrete edge TSDB (QuestDB) + cloud lakehouse (Iceberg/Parquet), durable store-
    and-forward with shedding tiers, event-time watermarking, egress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
2026-06-21 docs: Mark 1 2030 Technology Horizon (forward-looking 7-expert panel)
    Round-2 forward-looking review (2026 now -> 2030 launch). Governing principle all
    7 converged on: "lock contracts, build slots" — freeze friday_msgs schema/QoS,
    the signed-envelope security contract, issued_at event-time, and Iceberg/Arrow
    columns; make transport/silicon/inference/broker/sync swappable so 2030 tech
    drops in without a rebuild. Per-dimension 2030 bets (Zenoh fabric, NTN
    direct-to-device, hardware-agnostic inference slot, time-series foundation models
    for predictive maintenance, CRDT sync engine, Iceberg/Arrow lakehouse, agentic
    ops console), a 2026->2030 gate timeline, the no-regret 2026 moves, and the
    hig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
2026-06-21 feat: Phase 4 — safety (authority enforcement + safe-stop watchdog)
    Authority Lease Protocol + Safe-Stop Latency Budget, in code:
    - friday_msgs: AuthorityLease (holder + epoch + 2 s expiry), EmergencyStop
    (categories), FaultReport gains CATEGORY_WATCHDOG.
    - Core Hub (safety-supervisor lite): publishes the authority lease on
    /mark1/system/authority every 500 ms (holder MARK1-CORE-001) and a 20 Hz
    safety pulse modelling the owning-node firmware heartbeat.
    - Locomotion: pure safety.authorize() enforces source==holder + valid lease +
    monotonic nonce + command expiry (10 unit tests); rejects -> FaultReport,
    dropped. A 40 Hz watchdog trips SAFE-STATE (motors 0, steering frozen,
    Faul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
2026-06-21 docs: Phase 4 chapter — safety (authority + safe-stop, parallel with the code)
    Beginner-traceable walk-through of authority enforcement (the five accept/reject
    checks) and the safe-stop watchdog (one safe-state, three triggers), with the
    verified Legion results (10 authority tests; wrong-source/replay rejected;
    safety-pulse loss -> safe-stop at 112 ms), design rationale, a debugging guide,
    and honest not-done scope (split-brain failover, HIL 100 ms, command-router
    routing). Manual phase-map row -> in-progress, glossary + reading story updated,
    linked from the Mark 1 Index.
2026-06-21 docs: 7-expert delta re-review (round 2, after Phases 2-4 shipped)
    Same panel, now reading the real source. Score delta (app 3->3.5, system
    2.4->3; data/cloud/RF flat). Three code-grounded findings a doc review missed:
    (1) Phase 3 <-> Phase 4 don't compose — Telemetry stamps operator id as
    cmd.source but Phase 4 authority rejects non-holder -> end-to-end remote command
    is dead on arrival; (2) nonce is in-memory everywhere -> a reboot opens a replay
    window (the round-1 P0 is now a live regression); (3) the failure-data corpus is
    evaporating — FaultReports are emitted but never persisted. Plus a 3-item fix
    list (command-router re-stamp, persist nonce floor, ros2 bag record) sharing the
    Com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
2026-06-21 fix: close the 3 code-grounded P0s from the delta re-review
    1. Command-router re-stamp (Phase 3<->4 integration break): the Telemetry agent
    now tracks the authority lease and re-issues a validated operator command AS
    the lease holder (cmd.source = holder, monotonic issued nonce, operator expiry
    carried) instead of stamping the operator id — so Locomotion's authority check
    accepts it. End-to-end operator->rover command now composes.
    2. Durable nonce floor: new shared friday_module_agent/NonceStore persists the
    per-source nonce floor to an fsync'd file (atomic write before ACK); wired into
    the Telemetry CommandValidator and the Locomotion agent. A reboot no longer
    resets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
    [protocol.py, telemetry_agent_node.py]
2026-06-21 feat: Phase 4 split-brain failover (authority self-promote + clean hand-back)
    Completes Phase 4 per the Authority Lease Protocol addendum:
    friday_msgs: RequestAuthority.srv + ReleaseAuthority.msg (Mark1Header convention).
    friday_module_agent/authority.py: ROS-free should_failover (BOTH signals),
    accept_lease (epoch-monotonic), may_grant_return (not-behind AND stable);
    11 unit tests.
    friday_locomotion: _on_authority gates on accept_lease so a stale lower-epoch
    Core lease is ignored after failover (S3 keystone at the consumer).
    friday_core_hub: boot observe-window — clean boot takes epoch 1; rejoin requests
    a clean hand-back (RequestAuthority -> 500 ms quiet window -> publish at new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
    [telemetry_agent_node.py]
2026-06-21 feat(sim): Stage 1 friday_description — rocker-bogie URDF + Gazebo world + diff-drive control
    First-light Stage 1 sim package: six-wheel rigid chassis URDF (wheel positions
    measured from the scaled-Perseverance model, REP-103 frame), flat-ground Gazebo
    Harmonic world, gz_ros2_control + diff_drive_controller (skid steer, left 3 /
    right 3 wheels), and a headless sim launch. Plus Dockerfile.sim (Gazebo Harmonic
    + ros_gz + ros2_control atop the dev image). Articulated rocker-bogie pivots are
    the next refinement (TODO in the xacro).
    [diff_drive_controller.yaml, empty_ground.sdf, mark1.urdf.xacro]
2026-06-21 fix(sim): wrap robot_description xacro output as a string ParameterValue
    launch was trying to parse the URDF XML as YAML and crashing before spawn.
2026-06-21 feat(sim): articulated rocker-bogie suspension (passive rocker + bogie per side)
    Replaces the rigid chassis with the real passive linkage: per side a rocker
    (revolute, axis Y) on the body carrying the front wheel + a bogie carrying mid/
    rear wheels. Pure passive damped joints; wheels still measured-accurate at zero
    angle. Cross-body differential omitted (closed loop; noted).
    [mark1.urdf.xacro]
2026-06-21 fix(sim): rename xacro param len->arm_len (builtin clash) + launch on_stderr=ignore
    The 'len' macro param shadowed a xacro builtin, emitting a stderr warning that the
    launch Command treated as fatal, so the rover never spawned. Rename it and make the
    robot_description Command tolerant of benign xacro warnings.
    [mark1.urdf.xacro]
2026-06-21 docs: Stage 1 Gazebo walk-through + manual index row
    Accessible walk-through of the Stage 1 sim: rigid first-light -> articulated
    rocker-bogie, the locked Jazzy<->Harmonic stack, what's built, the verification
    results (spawn/stand z=0.097/drive 1.9m/11k-msg bag), and what's next.
2026-06-21 feat(sim): plug the real OS into Gazebo physics
    LocomotionAgent gains an optional wheel_cmd_topic param: when set, the same
    authority-gated, safe-stop-gated (v, w) is emitted as a TwistStamped wheel command
    (default empty -> node-sim behaviour unchanged). New sim_os.launch.py brings up the
    physics rover + the real Core Hub (authority lease + safety pulse + supervisor) +
    Locomotion (Phase 4 enforcement) wired to diff_drive. An authorized MotionCommand
    now drives Gazebo physics; losing the safety pulse safe-stops the physical rover.
2026-06-21 docs: Stage 1 — real OS drives physics + safe-stop (107 ms) verified
    Adds the sim_os walk-through (5d), verification rows, and marks the real-OS-in-sim
    item done: authorized MotionCommand drives the Gazebo rover; Core death safe-stops
    it at 107 ms (Phase 4 against physics).
2026-06-21 feat(sim): bumpy terrain world + selectable world arg + joint-state publisher
    Adds worlds/bumpy.sdf (two transverse ridges + an offset rock, ~0.5-0.7x wheel
    radius) to exercise the rocker-bogie; a 'world' launch arg on sim.launch.py; and a
    gz JointStatePublisher so the passive rocker/bogie angles are observable.
    [bumpy.sdf, mark1.urdf.xacro]
2026-06-21 fix(sim): raise rocker pivot above body CoM so the suspension self-levels
    The passive rockers were collapsing to their -0.7 limit (body pitched ~39deg)
    because the pivot sat below the body CoM (inverted pendulum). Raise the rocker
    pivot to z=0.28 and keep the body CoM low (z=0.18) so the sprung body hangs stably
    and self-levels, while the arms still articulate over bumps.
    [mark1.urdf.xacro]
2026-06-21 fix(sim): centre body CoM under the rocker pivots (x=0) so it hangs level
    Residual ~21deg pitch was the body swinging its forward CoM (x=0.05) under the
    pivot line (x=0). Align CoM to x=0 -> hangs level.
    [mark1.urdf.xacro]
2026-06-21 docs: Stage 1 — rocker-bogie self-levels + traverses bumpy terrain (verified)
    Records the self-leveling fix (rover sits level, z=0.070, pitch~0) and the bumpy
    traverse (6.1 m over 2 ridges + a rock, upright, no flip/stall). Corrects the
    earlier articulated-suspension claim (it was sitting pitched 21-39deg). Marks
    uneven-terrain done; live GUI is the open item (on the Legion PC).
2026-06-22 feat(sim): rebuild rover — rigid chassis + aligned rocker-bogie tube frame + Ackermann corner steering
    Replaces the unstable passive-articulated + skid-steer model (tipped on turns,
    sat cockeyed with a lifted wheel) with a clean rigid chassis: a tube frame whose
    arms actually connect each pivot to its wheels (visually aligned), all six wheel
    centres at z=0 so they rest flat together, and Ackermann CORNER STEERING (4 corner
    wheels steer about Z, 2 middle drive-only). ros2_control: 6 wheel velocity + 4
    steer position; new controllers.yaml + launch spawners. (Articulated flex is a
    later feature; sim_os.launch.py still needs a Twist->wheels/steer rework.)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
    [controllers.yaml, mark1.urdf.xacro]
2026-06-22 feat(sim): real OS drives the corner-steer rover (Ackermann kinematics)
    The Locomotion agent now converts an authorized, safe-stop-gated MotionCommand
    (v, w) into 6 wheel velocities + 4 corner steer angles via a pure, tested
    kinematics module (per-wheel body velocity v-w*y, w*x; corners roll along their
    heading, middles roll the forward component) and publishes to the gz_ros2_control
    command topics. sim_os.launch.py reworked: physics + Core Hub (authority + safety
    pulse + supervisor) + Locomotion wired to the wheel/steer controllers. So the real
    OS drives the corrected rover, and a Core death safe-stops it. 5 kinematics tests.
2026-06-22 fix(sim): safe-stop watchdog startup grace (avoid false-trip before pulse sub connects)
    The best-effort safety-pulse subscription can take >100 ms to connect after the
    node activates; the watchdog was tripping safe-stop in that window (then rejecting
    all commands as SAFE_STATE). Arm the watchdog ~1 s after activate. Runtime
    safe-stop latency on real pulse loss is unchanged (verified separately).
2026-06-22 fix(sim): parameterize safe-stop pulse timeout; loosen to 0.6s in sim_os
    Under the heavier corner-steer model the DDS safety pulse jitters (~15Hz with
    >150ms gaps) on the shared, physics-loaded CPU, false-tripping the 100ms watchdog.
    Make the timeout a param (default 0.1s = HIL firmware spec) and set 0.6s in sim_os
    so sim CPU jitter isn't mistaken for a real pulse loss. Real-hardware safe-stop is
    unchanged (100ms, HIL, separate path).
2026-06-22 docs: rewrite Stage 1 for corner-steer rebuild + real-OS-in-GUI
    Reflect what actually shipped: rigid chassis + Ackermann corner steering (the
    articulated rocker-bogie tipped on every turn — honest 3-try history), the pure
    kinematics.drive_and_steer maths, the wheel-velocity + steer-position controllers,
    the real OS driving it live in the Gazebo GUI, the safe_stop_timeout_s param (100ms
    HW / 0.6s sim), and the native-Docker-vs-Docker-Desktop RTF gotcha.
2026-06-22 feat(sim): Command Center boundary into sim (sim_cc.launch.py)
    Wire the Phase 3 Telemetry agent (signed-CBOR-over-MQTT boundary) into the sim
    alongside Core + Locomotion, so an operator-signed MotionCommand on the broker
    drives the physics rover end-to-end: operator -> CC -> broker -> Telemetry
    (validate Ed25519 + nonce + allowlist) -> re-issue as authority holder ->
    Locomotion -> motion. Core supervises locomotion + telemetry.
    Also add param-gated mTLS (mqtt_tls/ca/cert/key) + mqtt_client_id to the
    Telemetry agent for the live mutual-TLS EMQX broker; default off (plain local
    broker for node-sim + tests, unchanged).
    [telemetry_agent_node.py]
2026-06-22 docs: Stage 1 — Command Center boundary into sim (sim_cc) verified
    Record the operator -> CC -> broker -> rover -> motion loop proven against a real
    MQTT broker (valid drives 2.19 m; forged/expired/replay rejected at the boundary),
    and mark the live mutual-TLS EMQX hook-up as the remaining FCC-side step.
2026-06-22 test(telemetry): wire-contract golden vector (drift guard vs FCC envelope)
    protocol.py (rover) and bridge/envelope.py (FCC, separate repo) are two
    hand-maintained copies of the signed-envelope contract with no shared package and
    no cross-repo test — one edit to _signing_bytes silently breaks every signature.
    Pin a deterministic golden vector (fixed seed + fully-specified envelope -> exact
    _signing_bytes + Ed25519 signature hex). The FCC repo asserts the SAME constants;
    either side drifting goes red in CI. Surfaced by the FCC comms-layer audit.
2026-06-22 feat(telemetry): sign rover telemetry egress (odom/fault/ack)
    Close the return-path gap from the FCC comms audit: the rover now signs its
    outbound telemetry so the operator can prove it came from THIS rover (a spoofed
    position/detection/fault is rejected). protocol.sign_telemetry wraps build_envelope
    (sender=rover) — same signing path, so the wire-contract golden vector covers it.
    TelemetryAgent loads a rover key (rover_key_file param), bridges odom (downsampled
    to telemetry_rate_hz, default 2 Hz) + fault to mark1/<rover>/tlm/{odom,fault}, and
    signs the ACK. No key -> no egress (node-sim + tests unchanged). nav_msgs dep added;
    mock_command_center unwraps the signed ack.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
2026-06-22 docs: Stage 1 — signed telemetry return path verified
    Both directions of the Command Center boundary are now authenticated: the rover
    signs odom/fault/ack to mark1/<rover>/tlm/* (verified 66 odom + 2 ack + 1 fault,
    0 bad; tampered odom rejected).
2026-06-30 harden(telemetry): security-review fixes for telemetry signing
    Adversarial review of the signing change surfaced three items:
    - HIGH nonce race: NonceStore.commit replaces the whole dict, and the Telemetry
    CommandValidator (paho thread) + the issuing path (ROS executor) share one store
    -> a concurrent commit to a different source could lose an update. Add an internal
    threading.Lock guarding last()/commit() (fixes it for every caller/agent).
    - MEDIUM key-log redaction: _load_rover_key logged the raw exception, which can echo
    key-material fragments; log the exception TYPE only.
    - MEDIUM ack-format coverage: extract _build_ack_body (pure) + test BOTH the plain-CBOR
    (no key) and signed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
    [telemetry_agent_node.py]
2026-06-30 docs: refresh HANDOFF_LEGION for Stage 1 current state
    Old handoff was from pre-Stage-1 and treated 'open the GUI' as the immediate
    task + flagged a rocker-bogie tilt bug as open — both long since done. Replace
    with the actual Stage 1 reality: corner-steer rebuild, sim_os / sim_cc both
    live, signed telemetry both directions, native-Docker requirement, the working
    e2e recipe, and the two genuinely-open items (live FCC broker, allowlist
    refresh).
2026-06-30 docs: Mark 1 Interface Control Document (ICD) v0.1
    First wiring/signal contract for the real rover, locked to the reference design
    (6x XD-37GB555 on 6x DRV8871, 4-corner Ackermann 4x servo, 3S 12V, 2x Pi 4B +
    3x ESP32-WROOM-32 decks, micro-ROS over CP2102 serial). Per-deck WROOM-32 pin
    maps (Drive GPIO budget worked out), power rails, the 3-layer safe-stop chain
    (incl. the HIL 100ms watchdog), and the micro-ROS topic contract mapping the
    Locomotion agent's existing wheel/steer outputs onto the Drive/Steer decks.
2026-06-30 docs: Mark 1 electronics & motors procurement BOM (sourced, INR)
    Sorted, vendor-sourced BOM with live Indian prices, anchored on the chosen
    ThinkRobotics 37mm 12V/70RPM gearmotor (built-in 64 CPR quadrature encoder).
    Grand total ~Rs.26,200 new spend (2x Pi 4B + 3x ESP32 already owned). Includes
    buy-now-vs-later split and the encoder->PCA9685/PCNT ICD change (drops AS5600 +
    TCA9548A) plus the PCA9685/INA219 0x40 I2C address-collision catch.
2026-06-30 mechanics: add HowToMechatronics Perseverance replica CAD (Mark 1 mechanical reference)
    The complete buildable 1:4-scale Perseverance replica CAD — the canonical
    mechanical reference Mark 1's body is scaled from (the parts being printed come
    from here). Source: HowToMechatronics (Dejan Nedelkovski), CAD published 2023-11-30.
    Under Mechanics/reference-models/howtomechatronics-replica/ via git-LFS:
    - Perseverance_Replica_Assembly.step (full STEP assembly, FreeCAD-openable)
    - Perseverance_Replica_SOLIDWORKS.zip (editable source CAD)
    - stl/ : 105 parts (28 Main Functional, 20 Cameras, 57 Accessories)
    + README mapping the parts to Mark 1 (rocker-bogie, diff bar, 4-corner steer) and a
    licensing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
    [Accesories p1 - back left.STL, Accessiories p1-1.STL, Accessiories p15-2-Bottom.STL, Accessiories p15-2-Top.STL, Accessoires p1-2.STL, Accessoires p6-2.STL, Accessories - front panels.STL, Accessories - front sensor p2.STL]
2026-06-30 docs: revert wheel/scale to the DIY 130 mm (creator-confirmed); drop the 140 mm re-anchor
    The HowToMechatronics creator confirmed the source rover was scaled to a 130 mm
    wheel diameter and built around that + the servos/motors, with NO proportion
    calculations. So the 2026-06-19 re-anchor to 743 mm / 140 mm / 0.2668x (a Blender
    GLB re-measurement) was over-derived and wrong. Reverted across:
    - Mechanical Design Reference -> v1.2: wheel 130 mm, scale ~0.247x, in-repo DIY CAD
    is the dimensional source of truth; GLB derivation kept as flagged history.
    - Mark 1 Index, Deck Layout, Locomotion Build Package -> wheel 140->130 mm,
    r 0.070->0.065 m, body/wheelbase/track rescaled x130/140 + marked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
2026-06-30 sim: wheel radius 0.070 -> 0.065 (130 mm DIY wheel, in production)
    Match the sim to the production hardware: the DIY-replica wheel is 130 mm
    (creator-confirmed, parts printing). kinematics.WHEEL_RADIUS and the URDF
    wheel_radius -> 0.065; the URDF keeps wheel centres at the axle plane so the rover
    just settles 5 mm lower. mark1_sim_spec.md flagged superseded (it's the 140 mm
    articulated-model measurements; live sim is the rigid corner-steer model). Wheel
    POSITIONS left as the sim's model — re-derive off the in-repo DIY CAD later.
    [mark1.urdf.xacro]
2026-07-01 docs: two-OS split (friday-core-os + friday-telemetry-os) + BOM update
    Architecture: Mark 1 now runs two distinct OS images:
    - friday-core-os (Ubuntu 24.04 + ROS 2 Jazzy) on Pi 4B 8GB — Core Hub
    - friday-telemetry-os (Debian 12 Lite, no ROS 2) on Pi 3B+ 1GB — Telemetry Gateway
    Internal bridge: MQTT over Ethernet (signed CBOR envelopes, same format as CC link).
    Telemetry Gateway is a pure network gateway — no ROS 2, no DDS, no crypto.
    Safe-stop remains independent (Locomotion ESP32 hardware watchdog, 100ms).
    BOM: corrected inventory (1x Pi 4B 8GB + 1x Pi 3B+ 1GB + 4x ESP32 + 2x 4G dongles),
    added Telemetry Comms section (Heltec LoRa32 V3 + SIM cards). Total ~₹30,355.
    Repos provisio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
2026-07-13 fix(core_hub): capture live registry-bringup fixes (QoS, registry export, logger)
    These three fixes were made directly on the Pi during the 2026-07-12 ESP32
    registry bring-up and have been RUNNING live since, but were never committed
    (would be lost on a reflash). Capturing them verbatim:
    1. heartbeat_monitor() QoS (qos.py): the health-monitor SUBSCRIPTION must NOT
    request finite deadline/liveliness -- micro-ROS (XRCE) publishers can't OFFER
    them, so a requesting subscriber refuses the writer (incompatible QoS) and
    hears nothing. Same wire QoS as heartbeat() minus the deadline/liveliness
    request; liveness stays enforced by the registry age check. core_hub now
    subscribes heartb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
2026-07-14 feat(core-hub): supervisor reconcile loop — auto-wake managed boards
    The supervisor was a one-shot: fire once 3 s after startup, wait 5 s per
    node, skip permanently on a miss. Real ESP32 module boards arrive on their
    own clock (agent connect, watchdog restart + boot backoff, power cycles),
    so on a cold boot it skipped everything and the fleet stayed dark until a
    human ran change_state by hand.
    Replace it with a reconcile loop: every reconcile_period_s (default 10 s)
    read each managed node's lifecycle state and walk unconfigured -> configure
    -> activate / inactive -> activate. Idempotent (active nodes untouched),
    self-healing (a board that restarts mid-mission is re-woken next tick),
    non-b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
2026-07-14 feat(phone): phone sensor pod — Android GPS + IMU bridge (MARK1-PHONE-001)
    An old OnePlus 6T streams GPS (via GPSd Forwarder -> gpsd) and IMU
    (HyperIMU JSON/UDP) one-way over WiFi; friday_phone_bridge validates
    every packet and publishes /mark1/phone/fix + /mark1/phone/imu.
    - ModuleAgent lifecycle node, supervisor-managed (add 'phone' to managed_nodes)
    - hardware_type 'phone' -> /mark1/phone (avoids the ESP32 'sensor' namespace)
    - 60 s RegisterModule keep-alive (heals registry-wipe on Core-Hub restart)
    - silent phone = HEALTH_DEGRADED, heartbeat keeps running (advisory only,
    outside the safety path)
    - hostile-input posture: strict parse, per-field NaN policy, range gates,
    teleport rej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
2026-07-16 fix(core-hub): liveness honors a module's own OVERALL_FAULT verdict
    Found by a live TX-cut fault-injection test on the wired fleet: with only
    the Pi->board wire cut, a board latches its watchdog fault and sits in
    safe state -- but its intact TX wire keeps delivering 5 Hz heartbeats, so
    the hub classified it OK and the FCC showed a faulted fleet as live.
    Liveness (heartbeat age) answers 'is it talking'; it cannot answer 'is it
    well'. The hub now also subscribes each module's 1 Hz HealthStatus at
    registration and, when the module itself reports OVERALL_FAULT, classifies
    it LIVENESS_FAULT even if heartbeats are fresh -- the module's own verdict
    outranks a live wire. Registry export carries FAU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
2026-07-16 fix(core-hub): auto-recover latched faults + stop the FAULT flap
    Two gaps surfaced by a TX-cut-then-reconnect fault-injection test on the
    wired fleet (companion to PR #7's detection fix):
    1. No auto-recovery. A watchdog-latched board correctly stays safe-stopped
    until authority clears it -- but nothing issued the clear, so boards sat
    FAULT after the wire was reconnected (needed a manual deactivate->activate).
    The supervisor now detects a node that is lifecycle-ACTIVE yet DEAD/FAULT
    in liveness AND reachable (get_state answered), and re-cycles it
    deactivate->activate to clear the latch. A still-disconnected board never
    reaches this (its get_state does not answer), so recove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
2026-07-16 feat(envpod): environmental sensor pod bridge (Zero W SensorHub over WiFi)
    New rclpy module-agent package friday_envpod_bridge, mirroring the phone
    pod (PR #6). A Pi Zero W + DockerPi SensorHub HAT (no ROS: ARMv6) reads the
    HAT over I2C and streams one JSON datagram/second over WiFi UDP :5556; the
    bridge validates each packet and publishes:
    /mark1/envpod/temperature (sensor_msgs/Temperature)
    /mark1/envpod/humidity (sensor_msgs/RelativeHumidity)
    /mark1/envpod/pressure (sensor_msgs/FluidPressure)
    /mark1/envpod/illuminance (sensor_msgs/Illuminance)
    /mark1/envpod/presence (std_msgs/Bool)
    Registers MARK1-ENVPOD-001, hardware_type 'envpod' -> /mark1/envpod (clear
    of MARK1-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
2026-07-16 fix(module-agent): crash-proof spin loop — Python agents survive handler exceptions
    rclpy's LifecycleNode RAISES on an invalid change_state request (e.g.
    activate while unconfigured) instead of rejecting it; with a bare
    executor.spin() the exception unwinds main() and kills the process. Seen
    live: the envpod bridge crash-looped under systemd when mistimed
    transitions hit it during bring-up. The ESP32 rclc agents reject invalid
    transitions gracefully — this gives the Python agents the same resilience.
    New shared friday_module_agent.runner.spin_agent(): logs the handler
    exception loudly and re-enters spin; exits cleanly on Ctrl-C/shutdown.
    Both bridges (envpod, phone) switch their main()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
2026-07-16 feat(core-hub): extract the safety brain into pure, unit-tested decisions
    NASA-grade refactoring pass (audit annex A2's top complaint: the most
    safety-critical Pi logic had zero unit tests). The two judgments the hub
    makes about module safety are now plain functions over plain values in
    friday_core_hub/decisions.py:
    - classify_liveness(hb_age, health_overall, health_age) — OK/DEGRADED/
    DEAD/FAULT, incl. the TX-cut rule (a fresh self-reported FAULT outranks
    a live heartbeat) and the anti-flap rule (a stale FAULT ages out).
    - supervisor_action(lifecycle_state, liveness) — the reconcile loop's
    next transition, incl. the latched-fault recovery (ACTIVE+DEAD/FAULT
    and reachable -> dea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
2026-07-16 feat(core-hub): registry persistence — restore the roster on boot, DEAD until heard
    Audit annex A2/A3 gap: the registry was in-memory only, so a Core-Hub
    restart served the FCC an empty fleet until keep-alives trickled in
    (~60 s), and before the keep-alive era, forever.
    The registry.json export now doubles as the persistence record. On boot
    the hub restores every previously-known module via the normal register()
    path (same validation, same namespace derivation), resubscribes its
    heartbeat + health topics, and marks it DEAD-until-heard — we never fake
    a liveness we have not observed; real heartbeats promote to OK within
    seconds. New pure friday_core_hub/persistence.py owns snapshot parsi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
2026-07-16 feat(sim): Phase 0 senses — lidar + IMU on the sim rover
    2D gpu_lidar (360deg, 0.15-12 m, 10 Hz, frame lidar_link) and IMU (100 Hz,
    frame imu_link) added to the Mark 1 URDF; sensors + IMU systems added to
    both worlds; /scan and /imu bridged in sim.launch + sim_os.launch. Sim
    stand-ins for the future Research-Deck lidar and the Drive board's BNO085
    — same topics, same frames, so hardware arrival is a publisher swap.
    friday-os:sim image extended with nav2-bringup, slam-toolbox,
    robot_localization (autonomy stack for Phases 1-3).
    XML/compile-verified; headless sim verification pending the
    stage1/gazebo->main merge (branch predates the phone/envpod packages the
    current workspace expects).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
    [bumpy.sdf, empty_ground.sdf, mark1.urdf.xacro]
2026-07-16 fix(phone-bridge): parse HyperIMU's real CSV wire format
    Live bench capture (2026-07-16, first real phone connection) showed
    HyperIMU streams CSV — comma-separated floats, CRLF — not the JSON the
    bridge was built against, so all IMU datagrams were rejected (800+
    imu_parse drops while GPS worked fine).
    parse_imu_datagram now tries JSON first (kept for compatibility) and
    falls back to CSV: fields are the phone's ticked sensors in list order,
    mapped by csv_accel_index/csv_gyro_index parameters (defaults 0/3 = the
    documented accel+gyro-only setup). All existing range/finite gates apply
    — notably, a mis-mapped magnetometer masquerading as gyro (~36 'rad/s')
    is rejected by the range gate ra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
2026-07-16 feat(localization): Phase 1 — wheel odometry + EKF, the rover knows where it is
    Inverse kinematics added to friday_locomotion.kinematics: the two MIDDLE
    wheels never steer, forming a clean differential pair whatever the corner
    wheels do — body_twist_from_wheels() recovers (v, w) exactly from them
    (round-trip with drive_and_steer pinned by test), plus exact-arc
    integrate_pose(). New wheel_odometry node: /joint_states -> nav_msgs/
    Odometry on /odom, velocities trusted / pose covariances honest, and
    deliberately NO TF broadcast — robot_localization's EKF owns
    odom->base_link per REP-105 (config/ekf.yaml: fuse odom vx+vyaw with IMU
    yaw+yaw-rate, two_d_mode). Wired into sim.launch + sim_os.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
2026-07-16 feat(sim): Phase 2 — SLAM: the rover maps its world
    - config/slam.yaml: slam_toolbox online-async (scan + Phase-1 odom TF ->
    owns map->odom; REP-105 tree complete: map->odom->base_link->sensors).
    - Jazzy slam_toolbox is a LIFECYCLE node that sits unconfigured (our old
    friend) — nav2_lifecycle_manager (autostart) wakes it; both gated
    behind slam:=true in sim.launch + sim_os.launch.
    - worlds/arena.sdf: the bump-course ridges are 4-5 cm tall — invisible to
    a lidar scanning at 25 cm, so bumpy.sdf gave SLAM literally nothing to
    map (first run produced a 168x1 strip). The arena keeps the bump course
    for the suspension and adds an 8x8 m walled yard + 3 pillars + a crate
    at lidar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
    [arena.sdf]
2026-07-16 feat(locomotion): nav_motion_adapter — Nav2 rides the authority chain
    Nav2's Twist (/cmd_vel_nav) is translated to MotionCommand on
    /mark1/locomotion/cmd_motion under the CURRENT authority lease (source =
    holder, monotonic nonce, 0.5 s expiry). This is autonomy's ONLY path to
    the wheels — the locomotion agent's authority checks and safe-stop
    watchdogs stay between every plan and the motors. Commands are stamped
    in wall clock: the lease/expiry domain core+loco validate against.
2026-07-16 feat(description): Phase 3+4 — Nav2 autonomy in sim, gated nav:=true
    Minimal Nav2 stack (NavFn planner, Regulated Pure Pursuit controller,
    behaviors, bt_navigator + lifecycle autostart) tuned for the rover
    (0.28 m/s, park-anywhere yaw tolerance, skid rotate-to-heading). Global
    costmap consumes slam_toolbox's live /map; cmd_vel remapped to
    /cmd_vel_nav into the authority adapter. Verified headless in arena.sdf:
    NavigateToPose behind a pillar -> SUCCEEDED, 0.22 m from goal; mid-drive
    core_hub kill at 0.29 m/s -> SAFE-STOP in 605 ms, rover frozen while
    Nav2 still commanding.
2026-07-16 fix(os): fleet self-heals after a Core Hub restart (3 latent bugs)
    Found by the Phase 4 revive gate (cut the brain mid-drive, restart it,
    expect the rover to resume). Three independent gaps, each fatal alone:
    1. locomotion never SURFACED its latched safe-stop: health stayed OK, so
    the supervisor's FAULT-recover path could not see it. Now
    health_overall() -> FAULT + health_detail() 'safe-stop latched: <cause>'
    while latched (health timer only runs ACTIVE, so the flag there always
    means a latch, not a normal deactivate). New health_detail() hook on
    the ModuleAgent base replaces the hardcoded detail:'' (known gap).
    2. Python ModuleAgent had NO registration keep-alive (the ESP32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
2026-07-17 feat(description): exact replica body — CAD meshes + measured geometry
    The sim rover now wears the real body: visual meshes exported from the
    HowToMechatronics replica STEP assembly (chassis incl. rocker-bogie
    arms + mast, steering knuckles L/R, wheel) with primitive collisions
    kept for stable physics. Geometry trued to the measured CAD values
    (docs/build/MK1_Body_Anatomy.md): corners ±0.290/±0.268, middles
    -0.011/±0.301 (middles ride wider + slightly rear of center, like the
    real rover), wheel radius 0.065 -> 0.0668 (2.7% odometry scale error
    gone), width 0.0866. kinematics.py updated to the same numbers so
    steering math matches the body. GZ_SIM_RESOURCE_PATH appended in both
    launches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
    [chassis.stl, knuckle_fl.stl, knuckle_fr.stl, mark1.urdf.xacro, wheel.stl]
2026-07-17 fix(description): lidar rides the mast head; arena furniture raised to match
    With the real chassis mesh the old lidar mount (0.05,0,0.25) sat INSIDE
    the body: 2720 self-return triangles boxed the costmap in and Nav2
    could not plan at all (found by the isolated phase-3 gate — planner
    'Failed to create plan', behaviors 'Collision Ahead'). The lidar now
    mounts on the camera-mast head (0.193,-0.101,0.57), above every body
    part (mesh top 0.544, antenna 0.414) — which is the actual Mark 1 plan
    for the mast. Scan plane is now 0.64 m above ground, so arena walls go
    0.6->1.2 m, pillars 0.5->0.9 m, crate 0.4->0.8 m. maps/arena is stale
    (recorded from the old scan height); demos run live SLAM, rege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
    [arena.sdf, mark1.urdf.xacro]
2026-07-17 feat(telemetry): world-sense egress — signed tlm/env + tlm/gps to the operator
    The env pod and phone pod publish on the internal bus but never crossed
    the radio: the Command Center's new Environment panel sat honestly at
    LINK PENDING. The telemetry agent (already signing odom/fault outbound)
    now also carries the world senses:
    - caches the latest /mark1/envpod/{temperature,humidity,pressure,
    illuminance,presence} (proper sensor_msgs units -> operator units:
    RH 0-1 -> %, Pa -> hPa) and snapshots them on tlm/env every 5 s —
    only fields fresher than 30 s are included, and a silent pod
    publishes NOTHING (the operator view goes honestly stale, never
    frozen-fresh)
    - /mark1/phone/fix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
    [telemetry_agent_node.py]
2026-07-17 feat(phone): backup attitude — magnetometer, tilt, vibration, heading
    The phone pod is NOT a redundant IMU and this does not pretend otherwise:
    10 Hz over WiFi with arrival timestamps can never enter the localization
    filter (that stays the wired 100 Hz BNO085). It is a FALLBACK — when the
    real IMU dies the rover safe-stops as it always did, and these values
    tell the operator what state it stopped in: level or tipped, still or
    shaking, facing where.
    - ingest: parses the magnetometer (new csv_mag_index param; the OnePlus
    6T's 63-field HyperIMU stream carries it at 3-5, confirmed by live
    capture). Field-strength gate (15-90 uT) rejects magnet/motor
    distortion — a dropped mag keeps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
    [telemetry_agent_node.py]
2026-07-19 feat(sim): tlm:=true — the sim radios real signed telemetry to the FCC
    sim_os.launch gains the REAL telemetry agent behind tlm:=true, signing
    as the distinct rover identity MARK1-SIM-001 (own cert, own key, own
    broker ACL — the sim can never be mistaken for hardware). Secrets live
    in .sim-secrets/ at the workspace root (gitignored), mounted into the
    container as /ws/.sim-secrets. The supervisor manages the agent like
    any module (telemetry=MARK1-TLM-001 in managed_nodes).
    Verified live: the patrolling arena rover's odom (x, y, quaternion,
    velocity) signed -> EMQX mTLS -> gateway verify -> recorder, 2 Hz.
    Demo script now launches with tlm:=true — Gazebo drives, the deck
    watches, one pro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
2026-07-19 feat(telemetry): SLAM map egress — the whole known world in one envelope
    tlm/map carries the slam_toolbox occupancy grid over the radio: zlib
    over the raw cells, base64 so every hop stays JSON-clean, signed like
    all telemetry. Snapshot every 10 s but ONLY when the map's sha256
    changed — a parked rover radios nothing. Oversized maps (>256 KB
    compressed) are refused, never truncated. Transient-local subscriber so
    a late-joining agent still gets the latched grid.
    This is the Command Center's spatial awareness feed: sim today (the
    arena as the rover maps it), field rover the day it grows SLAM.
    138/138 tests (3 new: round-trip incl. unknown-cell encoding,
    unchanged-skip, oversize-refusal).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
    [telemetry_agent_node.py]
2026-07-19 fix(telemetry): radio the MAP-frame pose — the rover was rendering outside its own walls
    The odom egress signed the locomotion node's DEAD-RECKONED pose
    (integrated commanded velocities, zero feedback) — unbounded drift, and
    a different frame than the SLAM map. On the deck that truth-fully
    rendered a wrong number: the rover parked outside walls and ghosted
    through them, meters from reality after a 20-minute patrol.
    The agent now looks up map->base_link from TF (the same corrected frame
    the walls are drawn in) and radios THAT pose; when no SLAM/TF exists it
    falls back to dead-reckoning and says so — payload gains an honest
    'frame' field ('map' | 'dead-reckon'). Velocities stay from the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
    [telemetry_agent_node.py]
2026-07-19 feat(sim): 3D perception -> fused voxel world for the Command Center
    The 2D /scan can't see height, so the deck could only draw a floor-plan.
    This gives the sim real 3D eyes and streams the reconstruction:
    - URDF: a 16-ring 3D lidar (360deg, +/-15deg) + a forward depth camera
    on the mast. Verified: 2880 + 19200 points/frame.
    - telemetry agent fuses both clouds into an accumulating MAP-FRAME voxel
    world (10 cm cubes), floor/ceiling clipped, capped at 24k voxels
    (LRU-evicted), and streams it as signed tlm/voxel: int16 triplets,
    zlib+b64, digest-gated on growth, 256 KB refuse-ceiling. Whole 8x8
    arena world = ~7.4k voxels in a 22 KB signed envelope.
    Two bugs fixed on the way, both fo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
    [mark1.urdf.xacro]
2026-07-19 feat(sim): colour the 3D world + larger cap (RGB-D reconstruction)
    - arena objects painted distinctly (steel-blue walls, orange pillars,
    green crate) so there IS real colour to reconstruct.
    - depthcam depth_camera -> rgbd_camera: its point cloud now carries rgb.
    - voxel cap 24k -> 60k so the whole world persists (no eviction).
    - voxels carry colour: each voxel packs an RGB332 byte alongside its
    int16 coord. The 3D lidar has no colour (sentinel 0 -> deck
    height-tints); the RGB-D camera paints real colour where it looks, and
    a real colour is STICKY — a later colourless lidar hit refreshes
    recency but never repaints. So geometry comes from 360deg lidar,
    colour from the camera, fus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
    [arena.sdf, mark1.urdf.xacro]
2026-07-19 wip(sim): import PX4 Baylands outdoor world (runs at RTF 1.0 on the 3070)
    The 8x8 arena's replacement for outdoor autonomy: PX4's Baylands (407 MB
    Fuel coastal terrain, georeferenced California so GPS works), with our 5
    gz systems grafted in. PROVEN this world runs at real-time on the RTX
    3070 (nvidia-container-toolkit now installed) — RTF 0.02 on the AMD iGPU
    -> 1.0 on the NVIDIA GPU, ~50x, all 3 sensors intact.
    WIP — NOT navigable yet: needs a sensible flat spawn point on the
    terrain + SLAM/Nav2 settling + GPS wiring. Not launched by the demo
    until that lands. Committed to the branch so the import + the GPU proof
    aren't lost.
    [baylands.sdf]
2026-07-19 wip(sim): configurable spawn position (spawn_x/y/z) for outdoor worlds
    The arena spawned at a fixed (0,0,0.12); an outdoor world needs the
    rover placed on chosen ground. Adds spawn_x/y/z launch args. Part of
    the Baylands nav bring-up (WIP).
2026-07-19 fix(telemetry): NaN-guard cloud transform + dedicated cloud callback group
    Partial fix for the telemetry-agent heartbeat starvation seen after the
    EMQX recreate. NaN/inf-guard the point-cloud transform (was throwing
    RuntimeWarning + churning on bad startup TF); move cloud subs + voxel
    timer into a MutuallyExclusive callback group so they serialise on one
    thread instead of the heartbeat/lifecycle thread. 146 tests pass.
    INCOMPLETE: the agent still goes DEAD by heartbeat after activating
    (Command Center boundary comes up, then supervisor 'call unanswered
    30s'). Root cause is deeper — likely the MQTT publish/reconnect on the
    default-group thread blocking the heartbeat when talking to a
    fresh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
    [telemetry_agent_node.py]
2026-07-19 fix(telemetry): crash-proof spin + vectorized voxels (heartbeat WIP)
    Two genuine fixes landed here; the pipeline is still not fully restored.
    FIXED - crash-proof spin: the telemetry agent used a plain executor.spin()
    while every other module agent uses the crash-proof spin_agent runner.
    rclpy lifecycle nodes RAISE on an invalid transition, and the supervisor's
    recovery triggers one after a heartbeat miss -> the plain spin let that
    RCLError KILL the whole process (and all telemetry). Now wrapped in the
    same survive-and-re-enter loop. Verified: the agent process now survives
    (was dying with exit code 1).
    IMPROVED - vectorized voxel add_points (numpy fast path, ~50x) to rule out
    cloud-process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
    [telemetry_agent_node.py, voxels.py]
2026-07-19 fix(authority): close the epoch-quarantine incident class end to end
    Root cause chain (reproduced + profiled live in sim, 2026-07-19): the
    telemetry agent burned a full core through bring-up (deferred imports of
    tf2/numpy/point_cloud2 inside configure + rclpy logger caller-inspection),
    its minutes-long on_configure ran in the default mutually-exclusive
    callback group and starved the heartbeat, the lifecycle services AND its
    own view of the Core; the failover detector then read that starved cache
    as 'lease expired + pulse silent' and self-promoted to epoch 2 against a
    healthy Core; the later stand-down never announced the epoch, so
    consumers quarantined every epoch-1 Core lease forever.
    Fixe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
    [telemetry_agent_node.py]
2026-07-20 fix(sim): get Baylands outdoor world to full navigation
    Three bugs prevented the rover from navigating in Baylands:
    1. RPP spin-in-place (root cause): use_rotate_to_heading:true caused the
    controller to command pure rotation (v=0, w=0.15) before driving. The
    Mark 1's 4-corner steer limit (0.6 rad) cannot achieve the ~0.83 rad
    needed for a true point-turn, and sparse outdoor SLAM makes the map->odom
    TF oscillate at controller rate (10 Hz), capping angular velocity at
    max_angular_accel/frequency = 1.5/10 = 0.15 rad/s per step — it never
    ramps to the configured 0.5. Fix: use_rotate_to_heading: false.
    2. Controller activation race (root cause): joint_state_broadcaster and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
    [baylands.sdf]
2026-07-20 wip(rover): mission executor + GPS + navsat + mission planner (unfinished)
    Preserving in-progress work from the rover-mission-executor agent (hit
    session limit mid-retry-logic). Rover-side additions:
    * friday_telemetry/geo.py — WGS84 <-> map-frame helpers
    * friday_telemetry/mission_planner.py — lawnmower survey plan_survey()
    * telemetry_agent_node.py — mission executor state machine (dedicated
    callback group, MECE with vitals; enqueue-and-drain pattern);
    tlm/mission progress publisher
    * sim_os.launch.py + urdf + navsat_transform.yaml — GPS sensor + the
    utm->map anchor
    * nav2.yaml — tuning for outdoor SLAM
    * baylands.sdf — nav markers
    Known gap: waypoint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
    [baylands.sdf, mark1.urdf.xacro]
2026-07-20 feat(mission): best-effort survey — skip unreachable waypoints, keep going
    Outdoor terrain (Baylands and any real environment with slopes) makes
    some interior waypoints of a survey lawnmower unreachable — the SLAM
    costmap correctly registers slopes as walls, so Nav2 rejects those goals
    with STATUS_ABORTED. Old behaviour: retry the same waypoint up to 30
    times, then mark the WHOLE mission failed. Result: every real-world
    survey died on its first blocked cell after 150 s of wasted retries.
    New behaviour: 6 quick retries per waypoint (still handles the map-not-
    yet-built case), then SKIP the waypoint, count it as 'skipped', and
    advance to the next. Coverage percentage reflects skipped wayp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
    [telemetry_agent_node.py]
2026-07-20 fix(demo): nav2.yaml int-type + surface 'skipped' in mission telemetry
    Two small demo-critical fixes discovered in the pre-demo dry-run:
    1. nav2.yaml lines 96-97 had width/height as 60.0 (double) — Nav2's
    planner_server crashes on startup with 'parameter height has
    invalid type: setting int to double is not allowed'. Result:
    lifecycle_manager waits forever, mission executor can never send
    a goal. Changed to integer 60. Silent landmine from the earlier
    Baylands agent that would have killed the demo the moment we
    restarted the container.
    2. Mission progress telemetry (tlm/mission) now includes the
    'skipped' counter from the best-effort executor, so th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
    [telemetry_agent_node.py]
2026-07-20 feat(sim): bumper-height ground-scan RGB-D sensor for terrain intelligence
    Adds a 128×96 downward-tilted (30°) RGB-D depth camera at the front
    bumper (x=0.32, z=0.14, front of the front axle). Where the mast lidar
    sees the TOP of a slope (registers as wall in Nav2's flat costmap), this
    sensor sees the SURFACE ahead of the wheels. Downstream terrain
    classifier will use it to distinguish 'climbable slope' from 'vertical
    wall'.
    Sensor: gpu rgbd_camera, 10 Hz target, FOV 60°, near 5 cm, far 3 m.
    Fixed joint to base_link (no articulation). Bridged as
    /ground_scan/points (PointCloud2, gz.msgs.PointCloudPacked).
    Verified live: /ground_scan/points publishing at 4.7 Hz, 12288 dense
    points per fr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
    [mark1.urdf.xacro]
2026-07-20 feat(terrain): classifier node — 'the rover reads the ground before deciding'
    New package friday_terrain with terrain_analysis_node — the intelligence
    layer between ground-scan RGB-D and Nav2 planning.
    The mast lidar cannot distinguish 'climbable slope' from 'vertical wall':
    the flat SLAM costmap marks anything raised as an obstacle. The bumper
    sensor sees the surface directly ahead of the wheels; this node turns
    that into a rolling 2D grid centred on the rover and classifies each
    cell by slope + step:
    FLAT (< 10 deg, step < 3 cm) -> cost 0
    GENTLE (10-20 deg) -> cost 40
    STEEP (20-30 deg) -> cost 70
    ROUGH (step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
2026-07-20 fix(terrain): add setup.cfg to install entry_point in lib/<pkg>/ for ros2 launch
    Matches the pattern used by friday_telemetry: without setup.cfg the
    executable lands in bin/ (pip default) rather than lib/<pkg>/ where
    ros2 launch expects it — causing 'libexec directory ... does not exist'
    on launch. This is a ROS 2 ament_python quirk; fixed once, no runtime
    effect.
    Verified live: terrain_analysis node spawns and publishes /terrain/costmap
    at 4.9 Hz on the arena world.
2026-07-20 fix(terrain): cliff threshold — real precipice, not gentle downhill
    Cliff threshold was wheel-radius (-6.68 cm below base) — too tight.
    On any downhill terrain, sensor points landed at z=-0.3 to -0.5 in
    the base_link frame, triggering LETHAL_CLIFF on cells that were just
    gently sloping ground. Baylands live: 232 spurious cliff cells out
    of 242 seen — everything ahead read as lethal.
    New threshold: -0.50 m (chassis-bottom drops > 50 cm = a real drop
    the rover can't recover from). Slope classification (already covered
    by SLOPE_ rules) handles gentle downhills correctly.
    Verified live on Baylands: same 242 cells seen, but now correctly
    classified as 173 FLAT + 4 GENTLE + 53 STEEP + 12 L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
    [terrain_analysis_node.py]
2026-07-20 feat(nav): Nav2 consumes terrain intelligence — the rover uses what it sees
    Wires the terrain classifier output into Nav2's global obstacle_layer as
    a second observation source, alongside the existing mast lidar scan.
    Rover side:
    * terrain_analysis_node publishes a NEW topic /terrain/obstacle_points
    (PointCloud2, base_link frame, one point at chassis-height for every
    cell the classifier deemed LETHAL_STEP / LETHAL_SLOPE / LETHAL_CLIFF).
    Empty cloud published every frame so obstacle_layer's clearing
    raytrace prunes stale marks when the classifier changes its opinion.
    Nav2 side:
    * global_costmap/obstacle_layer now lists observation_sources: scan terrain
    * scan (existi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
2026-07-20 feat(telemetry): sign + emit /terrain/summary as tlm/terrain (1 Hz)
    Fourth of four commits in the terrain-intelligence arc: gets the
    classifier's output to the operator through the trusted signed
    telemetry envelope, so the FCC can record and display what the rover
    is reading about the ground ahead of it.
    Details:
    * Subscribes to /terrain/summary (std_msgs/String JSON from the
    terrain_analysis node — class histogram + coverage percentage).
    * Caches the latest JSON, re-publishes at 1 Hz as tlm/terrain with
    class='terrain' and the full class histogram in the payload.
    * Signed with the rover's Ed25519 key like every other tlm/* topic —
    the FCC gateway verifies signature an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
2026-07-20 revert(nav): unplug terrain from Nav2 obstacle_layer — sensing stays, enforcement out
    Terrain intelligence was fed into Nav2's global obstacle_layer as a hard
    obstacle source (commit 18ebef3). On natural outdoor terrain (Baylands)
    a few cells in front of the rover are always classified lethal, so Nav2
    refused to plan ANY path — the rover sat still, the SLAM map never grew,
    and the deck looked frozen. A binary lethal-mark is the wrong integration
    for terrain: it belongs as a COST GRADIENT (steep = expensive but
    plannable), which requires a proper nav2_costmap_2d::Layer plugin.
    This revert:
    * nav2.yaml global obstacle_layer back to observation_sources: scan
    (mast lidar only). Rover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
    [terrain_analysis_node.py]
2026-07-20 feat: rover-side autonomy-mode enforcement harness (Mark 1)
    Implements the rover half of the L0-L3 autonomy gate contract so that a
    signed cmd/mode from the FCC actually constrains wheel motion, not just
    persists a config value.
    Contract surface (exact match for FCC engineer parity):
    Topic : /mark1/system/autonomy_mode
    Type : std_msgs/Int8
    QoS : reliable + transient_local + keep_last 1 (latched)
    Default: 0 (Manual) published once at telemetry agent activate
    Changes:
    friday_telemetry/telemetry_agent_node.py
    - Import Int8 from std_msgs.msg
    - _autonomy_level/mission_profile/brain state in __init__ (default L0)
    - /mark1/system/autonomy_mode lifecycle publisher in configur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
2026-07-20 feat(mission): L2 Supervised approval round-trip — rover pauses, operator approves
    Completes the autonomy harness (Stage 3). Under L2 Supervised, the rover
    plans and executes but pauses before EACH waypoint goal for operator
    approval — 'rover plans and executes; operator approves key decisions.'
    Mission executor (_mission_advance): when autonomy_level==2 and the
    current waypoint isn't yet approved, set awaiting_approval + pending_wp,
    publish progress, and HOLD (no Nav2 goal) until a decision arrives. The
    gate is on the GOAL, not low-level motion — motion_allowed(2) still True
    at the wheel gate, so approved waypoints drive normally.
    _handle_mission_cmd: new 'approve'/'deny' ops. appro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
2026-07-20 feat(nav): TerrainLayer gradient costmap plugin — replaces binary obstacle with cost
    Implements friday_nav_layers::TerrainLayer, a nav2_costmap_2d::Layer plugin
    that converts the Mark 1 terrain classifier's /terrain/costmap (OccupancyGrid,
    base_link frame, 60x60 cells @ 0.10m) into gradient Nav2 cost instead of
    the binary lethal marks that caused planning failures on natural outdoor slopes.
    Cost mapping:
    -1 (unknown) → skip (leave master costmap cell untouched)
    0 (flat) → 0 FREE_SPACE
    40 (gentle) → 101 (~40% of max gradient)
    60 (rough) → 151
    70 (steep) → 176
    100 (lethal) → 254 LETHAL_OBSTACLE
    1-99 → round(val * 252.0 / 100.0), capped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
2026-07-21 Operator terrain sense: traversability ribbon + bumper-cam keyframes (#28)
    * feat(terrain): map-frame traversability accumulator for operator terrain sense
    The terrain classifier's /terrain/costmap is robot-centred + instantaneous (right for
    Nav2's local costmap). An operator needs the opposite: a persistent map-frame ribbon of
    what terrain has been sensed, and where, along the mission path. terrain_map stamps each
    reading into a world grid (worst-case-sticky per cell — a cliff seen once stays a cliff),
    anchored on the rover's first position so it follows real map coordinates (not a fragile
    fixed origin), and republishes /terrain/map_grid for RViz + telemetry forwarding.
    Verified offline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
    [telemetry_agent_node.py, terrain_map_node.py]
2026-07-21 Make Baylands demo drive: outdoor terrain-lethal + lidar obstacle-gating fixes (#29)
    * fix(terrain): raise lethal STEP threshold 13cm->25cm for outdoor traversability
    On Baylands, grass/pebble roughness within a 10cm cell routinely exceeds 2x wheel radius
    (13cm), so 36% of cells were flagged LETHAL_STEP -> Nav2 could not path. 25cm is genuine
    obstacle/curb height; below it, outdoor roughness now classifies as rough/steep (passable,
    high-cost) not lethal. Live effect: terrain-lethal cells 36% -> 0.
    NOTE: this alone does not make the Baylands demo drive — the 3D lidar obstacle_layer still
    marks Baylands vegetation/terrain as obstacles (separate lidar-filtering issue).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
    [terrain_analysis_node.py]
2026-07-21 perf(telemetry): reduce inbound drain timer from 50 Hz to 20 Hz (#30)
    The MQTT→DDS drain timer was firing at 50 Hz but the queue is almost
    always empty between commands (operator rate <<1 Hz). Worst-case command
    dispatch latency rises from 20 ms to 50 ms, which is within the round-trip
    budget of any human-issued motion command.
    Saves ~30 Python rclpy callbacks/second in the telemetry agent, which was
    observed running at 90%+ CPU with the combined timer + subscription load.
    [telemetry_agent_node.py]
